doyun-gu/hack-a-bot-2026/README.md

# GridBox — Smart Infrastructure Control System

<p align="center">
  <a href="https://hackabot-2026.com">Hack-A-Bot 2026</a>
  &nbsp;&nbsp;&nbsp;&nbsp;&nbsp;
  
</p>

<p align="center">
  <strong>A £15 smart factory controller — built in 24 hours</strong><br/>
  21 Mar 2026 12:00 — 22 Mar 2026 12:00
</p>

<p align="center">
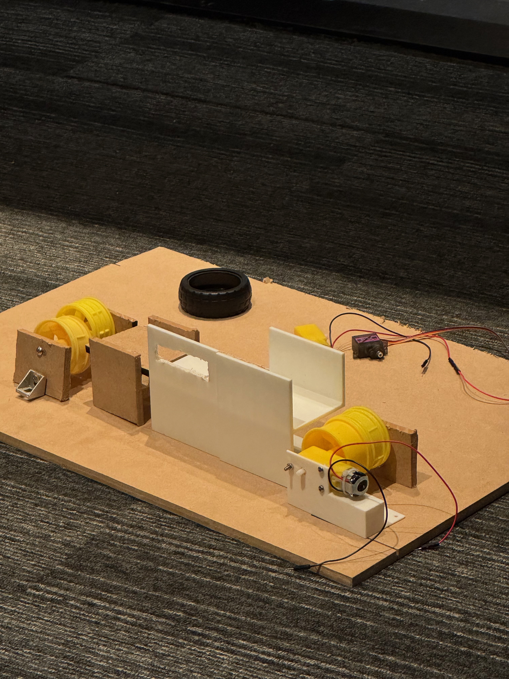
[picture p1: docs/images/build/chassis_assembled.jpeg]
GridBox — Assembled Sorting Conveyor
  
  &nbsp;&nbsp;
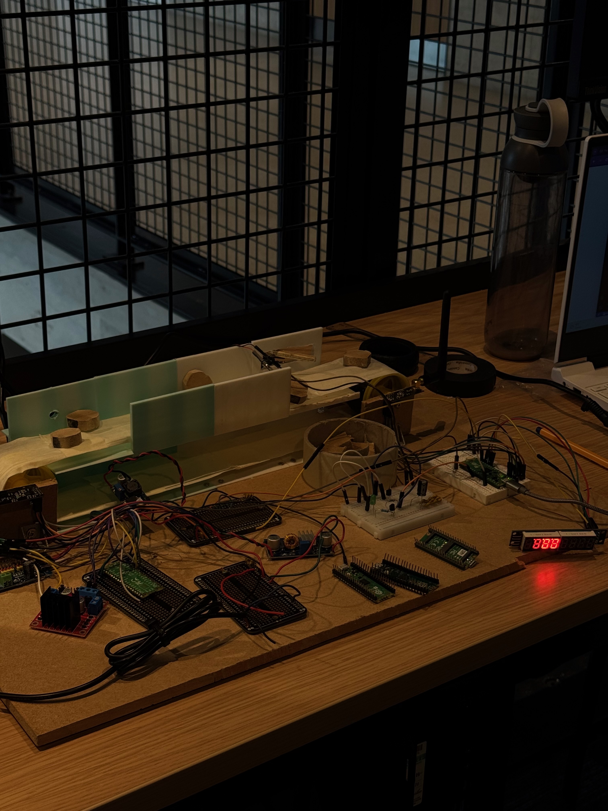
[picture p2: docs/images/build/full_system.jpeg]
GridBox — Full System with Electronics
  
</p>

<p align="center">
  <a href="docs/01-overview/gridbox-design.md">Design Doc</a> · <a href="docs/01-overview/context.md">Project Context</a> · <a href="docs/02-electrical/wiring-connections.md">Wiring Guide</a> · <a href="docs/04-team/team-plan.md">Team Plan</a>
</p>

---

## What We Built

GridBox is a miniature **smart factory** — a water bottling / sorting plant powered by recycled energy. Two Raspberry Pi Pico 2 boards work together wirelessly: one controls the factory floor, the other is a remote SCADA monitoring station.

```mermaid
graph LR
    ENERGY[Recycled Energy] --> PICO_A[Pico A: Factory Controller]
    PICO_A --> M1[DC Motor: Fan/Pump]
    PICO_A --> M2[DC Motor: Conveyor]
    PICO_A --> S1[Servo: Valve]
    PICO_A --> S2[Servo: Sort Gate]
    PICO_A -->|"nRF24L01+ wireless"| PICO_B[Pico B: SCADA Station]
    PICO_B --> OLED[OLED Dashboard]
    PICO_B --> SEG[MAX7219 7-Segment]
    PICO_A -->|"USB serial"| WEB[Laptop: Web Dashboard]
```

### Key Features

| Feature | How It Works |
|---|---|
| **Smart power management** | ADC senses current at every branch. Pico reroutes excess power. $P \propto n^3$ — 20% slower = 49% less energy |
| **Autonomous fault detection** | IMU vibration monitoring (ISO 10816) + current signature analysis. Detects bearing wear, jams, loose connections |
| **Intelligent load shedding** | Bus voltage drops → system sheds non-essential loads by priority. Critical systems stay powered |
| **Weight-based sorting** | Motor current change = item weight. Timed servo gate sorts good/bad at the end of the belt |
| **Wireless SCADA** | 6-type binary datagram protocol at 50Hz. OLED dashboard with 5 views. MAX7219 7-segment live status display |
| **Failure simulator** | Inject faults during demo — judges watch the system handle wireless dropout, motor stall, power sag, IMU failure |
| **Web dashboard** | Live graphs on laptop via USB serial. SQLite database for persistent data logging |

### The Demo

| Step | What Happens |
|---|---|
| 1 | Power on — system auto-starts, motors spin, LEDs green |
| 2 | Wireless SCADA — Pico B display shows live speed, angle, fault status |
| 3 | Place items on conveyor — sorted by weight into PASS / REJECT bins |
| 4 | Shake motor — fault detected in <100ms, motor stops, power reroutes |
| 5 | Auto-recovery — vibration drops, system restores loads automatically |
| 6 | Energy summary — "Smart mode saved 69% energy vs dumb mode" |

---

## Themes

<p align="center">
  <strong>Sustainability</strong> — Smart energy management, waste reduction, recycled power<br/>
  <strong>Autonomy</strong> — Sense, decide, and act with zero human input
</p>

---

## Tech Stack

| Layer | Technology |
|---|---|
| **Microcontrollers** | 2× Raspberry Pi Pico 2 (RP2350, ARM Cortex-M33, dual-core) |
| **Wireless** | nRF24L01+ PA+LNA, 2.4GHz, custom 6-type binary datagram protocol |
| **Sensors** | BMI160 IMU (vibration), ADC (voltage + current via 1Ω sense resistors) |
| **Actuators** | 2× DC Motor (200RPM geared), 2× MG90S Servo, via PCA9685 PWM driver |
| **Display** | 0.96" SSD1306 OLED (128×64, 5 views) + MAX7219 8-digit 7-segment |
| **Switching** | Motor driver module + 2N2222 NPN transistor for energy recycling |
| **Firmware** | MicroPython (development) + C SDK (production demo) |
| **Dashboard** | Flask + SQLite + live graphs on laptop |
| **Power** | 12V PSU → LM2596S buck (5V logic) + 300W buck-boost (motor power) |

---

## Repository Structure

```
hack-a-bot-2026/
├── test.sh                         ← One command for all tests: ./test.sh led, ./test.sh oled, etc.
│
├── firmware/                       ← Frozen firmware snapshots (flash directly)
│   ├── 01-v1/                      ← MicroPython v1 (21 modules)
│   ├── 02-v2/                      ← + datagram protocol, self-test, A/B comparison
│   ├── 03-v3/                      ← + mock data, C stubs, integration test
│   └── 04-v4/                      ← + wireless verified, architecture diagrams
│
├── src/                            ← Development source code (11,500+ lines)
│   ├── master-pico/
│   │   ├── micropython/            ← Pico A: 14 MicroPython modules
│   │   ├── c_sdk/                  ← Pico A: C production firmware (5 drivers + main.c)
│   │   └── tests/                  ← 15 hardware test scripts
│   ├── slave-pico/
│   │   ├── micropython/            ← Pico B: 9 MicroPython modules
│   │   ├── c_sdk/                  ← Pico B: C production firmware (3 drivers + main.c)
│   │   └── tests/                  ← 6 display + wireless test scripts
│   ├── shared/protocol.py          ← 6-type binary datagram protocol (32-byte packets)
│   ├── web/                        ← Flask dashboard + SQLite + mock data generator
│   ├── hardware/electronics/       ← Circuit schematics + test logs (Wooseong)
│   ├── hardware/chassis/           ← CAD + 3D print files (Billy)
│   └── tools/                      ← setup-pico.sh, flash.sh, setup-pico1.sh
│
├── docs/
│   ├── 01-overview/                ← Design doc, proposal, context, quick-start, project summary
│   ├── 02-electrical/              ← Wiring, power system, datagram, debug, failure handling,
│   │                                  motor specs, wireless reliability, energy signature
│   ├── 03-factory/                 ← Factory design, conveyor calcs, weight sensing, demo script
│   ├── 04-team/                    ← Team plan + task lists
│   └── 05-archive/                 ← Past ideas explored
│
└── media/                          ← Build progress photos + demo videos
```

---

## Codebase Stats

**259 source files — 44,186 lines of code**

### By Language
| Language | Lines |
|---|---|
| Python | 36,799 |
| C/C++ | 5,673 |
| Shell | 928 |
| HTML | 786 |

### By Component
| Component | Lines | What |
|---|---|---|
| Firmware snapshots | 25,336 | 4 frozen releases (v1–v4) |
| Master Pico | 8,509 | MicroPython + C SDK + 15 tests |
| Slave Pico | 4,989 | MicroPython + C SDK + 6 tests |
| Demo | 1,674 | Integration demo scripts |
| Web Dashboard | 1,325 | Flask + SQLite + HTML |
| Tools/Scripts | 1,260 | Flash, build, test scripts |
| Shared Protocol | 358 | Wireless datagram protocol |

---

## Build Gallery

<table>
<tr>
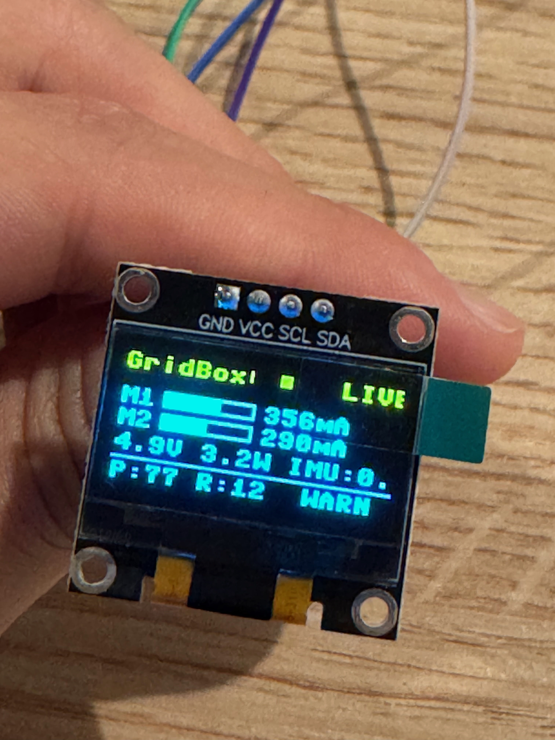
[picture p3: docs/images/build/oled_live.jpeg]
<td align="center" width="33%"><br/><em>OLED SCADA display — live readings</em></td>
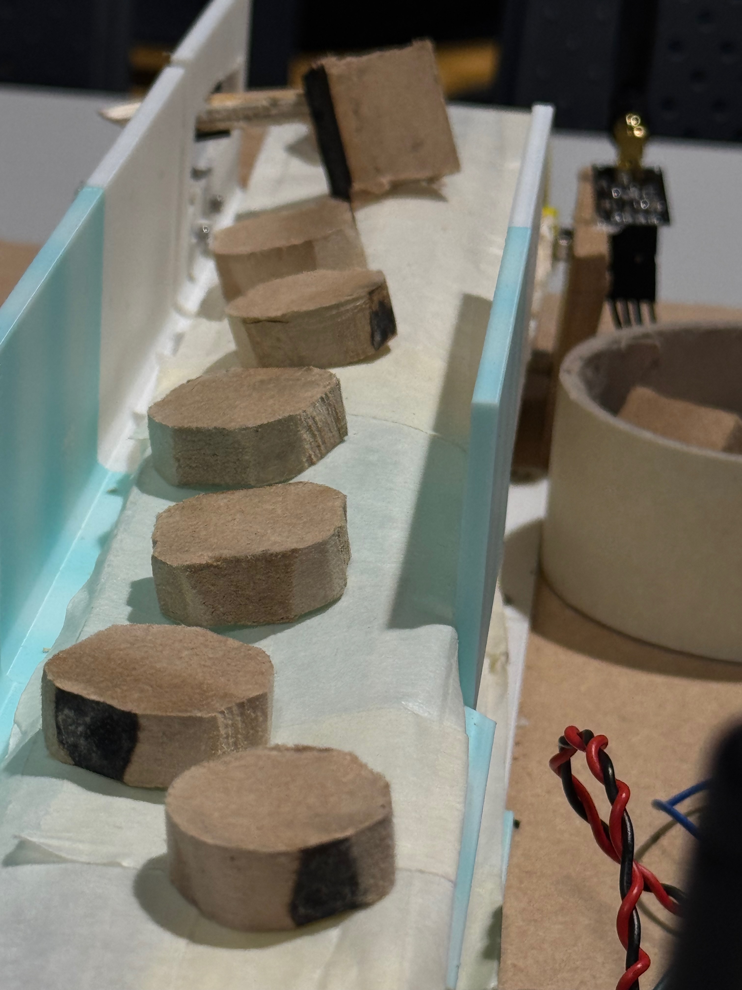
[picture p4: docs/images/build/conveyor_closeup.jpeg]
<td align="center" width="33%"><br/><em>Sorting conveyor with test objects</em></td>
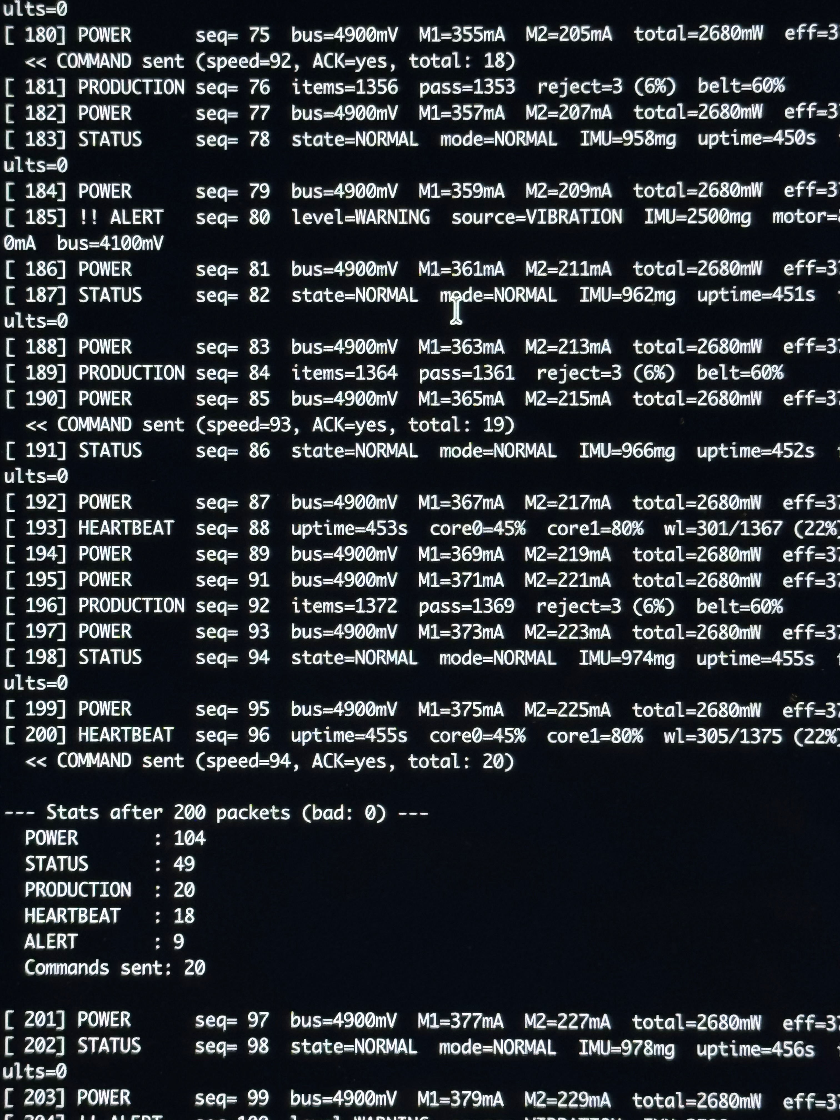
[picture p5: docs/images/build/wireless_test.jpeg]
<td align="center" width="33%"><br/><em>Wireless protocol — 200+ packets, 0 errors</em></td>
</tr>
<tr>
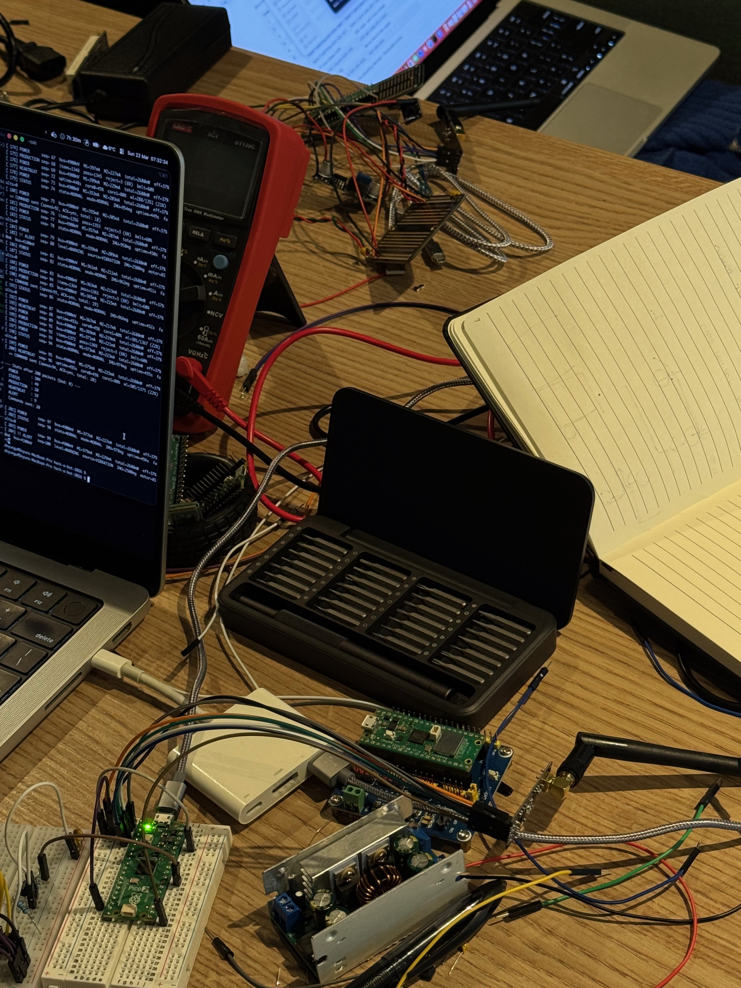
[picture p6: docs/images/build/workbench.jpeg]
<td align="center" width="33%"><br/><em>Electronics workbench</em></td>
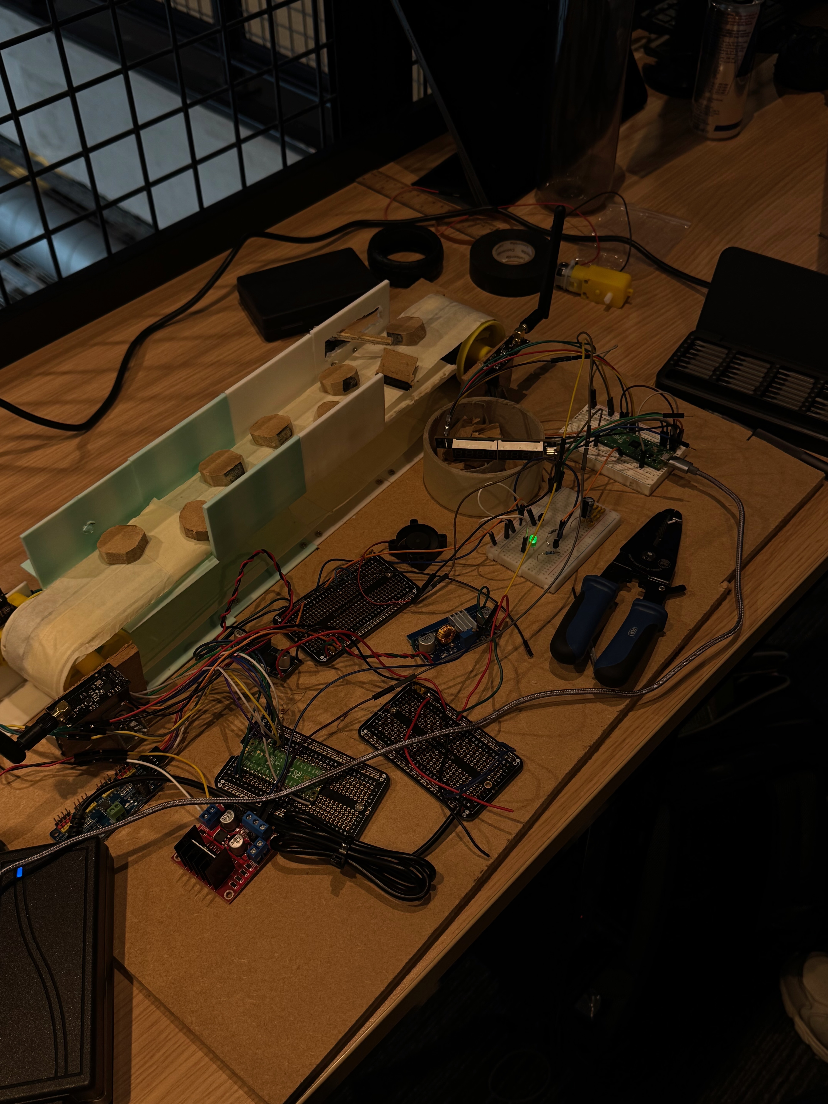
[picture p7: docs/images/build/integration.jpeg]
<td align="center" width="33%"><br/><em>Full integration — chassis + electronics</em></td>
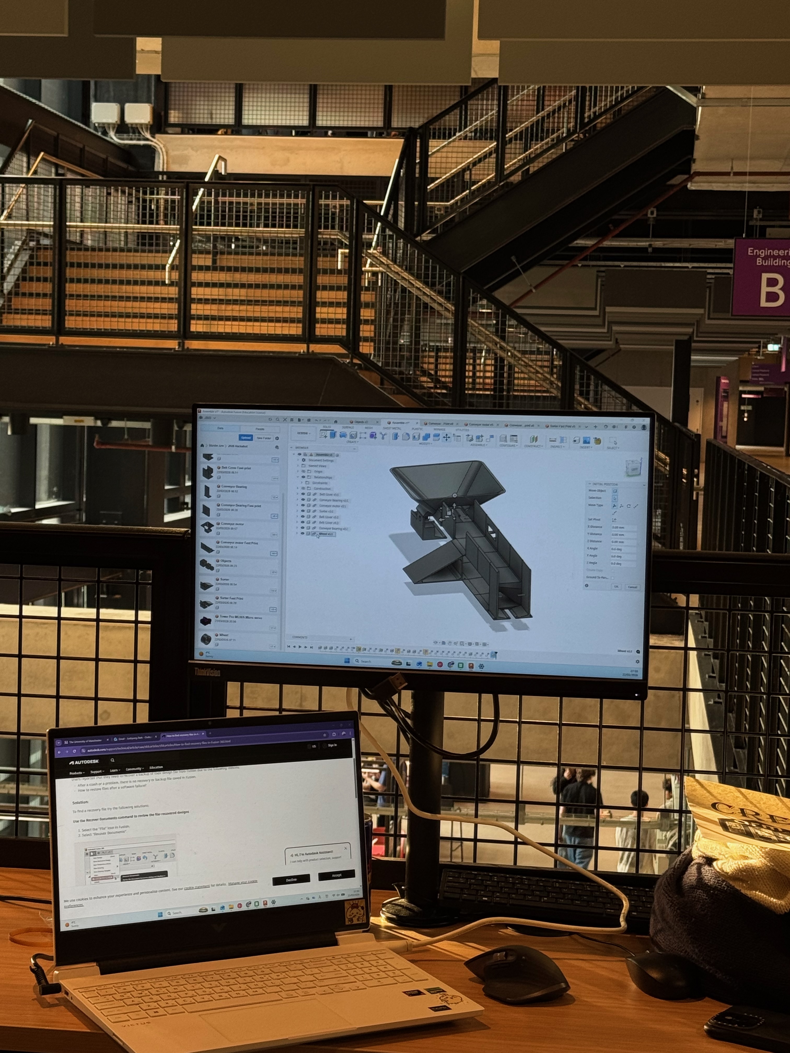
[picture p8: docs/images/build/cad_workstation.jpeg]
<td align="center" width="33%"><br/><em>Billy designing chassis in Fusion 360</em></td>
</tr>
</table>

<p align="center">
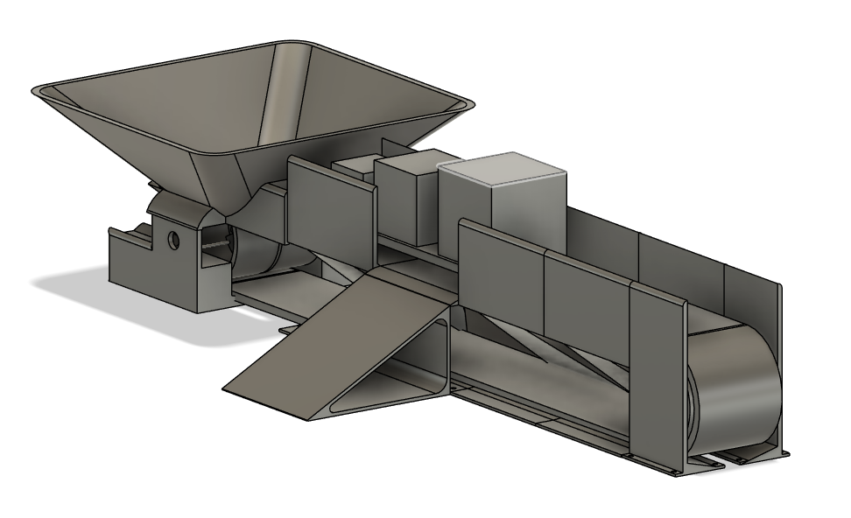
[picture p9: docs/images/chassis_cad.png]
<br/>
<em>CAD render — sorting conveyor designed by Billy Park in Fusion 360</em>
</p>

---

## Supported By

<table align="center">
<tr>
<td align="center"><a href="https://www.arm.com">ARM</a></td>
<td align="center"><a href="https://manchesterstudentsunion.com/activities/view/eeesoc">EEESoc</a></td>
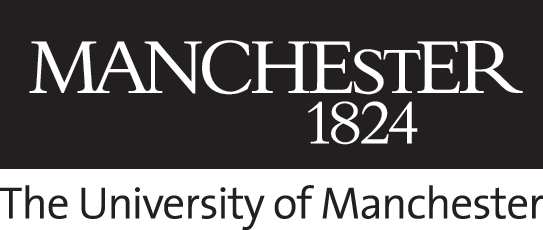
[picture p10: docs/images/uom_black.png]
UoM
<td align="center"></td>
<td align="center"><a href="https://www.makerspace.manchester.ac.uk">Makerspace</a></td>
<td align="center"><a href="https://www.quanser.com">Quanser</a></td>
</tr>
<tr>
<td align="center"><a href="https://www.intechopen.com/profiles/213610">Ice Nine</a></td>
<td align="center"><a href="https://www.amentum.com">Amentum</a></td>
<td align="center"><a href="https://www.dominos.co.uk">Dominos</a></td>
<td align="center"></td>
<td align="center"></td>
</tr>
<tr>
<td align="center"></td>
<td align="center"></td>
<td align="center"></td>
<td align="center"></td>
<td align="center"></td>
</tr>
</table>

<p align="center">
  <em><a href="https://hackabot-2026.com">Hack-A-Bot 2026</a> — Project 6: Creative — University of Manchester</em>
</p>
