doyun-gu/hack-a-bot-2026/docs/ideas/README.md

# Ideas Archive

Brainstorming and alternative ideas explored before choosing GridBox. Kept for reference.

| File | Score | Idea |
|---|---|---|
| [`idea-shortlist.md`](idea-shortlist.md) | — | Original 10 ideas (base kit only) |
| [`idea-shortlist-v2.md`](idea-shortlist-v2.md) | — | Expanded 14 ideas (with DC motor, ESP32-CAM, wheels) |
| [`tremortray-proposal.md`](tremortray-proposal.md) | 98 | NeuroSync — neurological diagnostic platform |
| [`steadyhand-proposal.md`](steadyhand-proposal.md) | 95 | SteadyHand — tremor-stabilising device |

**Chosen idea:** GridBox → see [`docs/gridbox-design.md`](../gridbox-design.md)
