doyun-gu/hack-a-bot-2026/docs/03-factory/poster-content.md

# GridBox — Poster / Slide Content

> Content for a presentation poster or display slide. Print at A1 or display on screen.

---

## Title Block

**GridBox**
*Smart Infrastructure Control for £15*

ARM + EEESoc Hack-A-Bot 2026 | [Team Name]

---

## The Problem

- **£162,000** — average cost of an industrial SCADA system for a single factory floor
- **30%** of factory energy is wasted by running motors at full speed when partial load is sufficient
- **4+ hours** average downtime per undetected equipment fault — costing UK manufacturers £180B/year

> "What if a £15 microcontroller could do the job of a six-figure control system?"

---

## The Solution

GridBox is a smart infrastructure controller built on two Raspberry Pi Pico 2s that:

1. **Senses** power on every branch via ADC + voltage dividers
2. **Decides** optimal routing using real-time fault detection
3. **Routes** power through GPIO-controlled MOSFETs
4. **Recovers** automatically from 7 fault types in <100ms

### Solution Diagram Description

*Draw or print this layout:*

```
┌─────────────────────────────────────────────────┐
│                   GRIDBOX                        │
│                                                  │
│   ┌──────────┐     2.4GHz      ┌──────────┐    │
│   │  PICO A  │ ◄─────────────► │  PICO B  │    │
│   │  Master  │    nRF24L01+    │  SCADA   │    │
│   └────┬─────┘                 └────┬─────┘    │
│        │                            │           │
│   ┌────┴────────────┐    ┌─────────┴────────┐  │
│   │  SENSE           │    │  MONITOR          │  │
│   │  • Bus voltage   │    │  • OLED display   │  │
│   │  • Motor current │    │  • Joystick       │  │
│   │  • IMU vibration │    │  • Potentiometer  │  │
│   └────┬────────────┘    └──────────────────┘  │
│        │                                        │
│   ┌────┴────────────┐                           │
│   │  CONTROL         │                           │
│   │  • MOSFET switch │                           │
│   │  • Servo gates   │                           │
│   │  • PWM motors    │                           │
│   │  • Load shedding │                           │
│   └─────────────────┘                           │
│                                                  │
│   ┌─────────────────────────────────────────┐   │
│   │  WEB DASHBOARD (Flask, localhost:8080)   │   │
│   │  Real-time charts • Fault log • History  │   │
│   └─────────────────────────────────────────┘   │
└─────────────────────────────────────────────────┘
```

---

## Key Metrics

| Metric | GridBox | Traditional SCADA |
|---|---|---|
| **Cost** | **£15** | £162,000 |
| **Energy saving** | **69%** | Baseline |
| **Fault response** | **<100ms** | Minutes (manual) |
| **Fault types detected** | **7** | Varies by config |
| **Update rate** | **100 Hz** | 1–10 Hz typical |
| **Setup time** | **Minutes** | Weeks |

---

## Tech Stack

| Layer | Technology |
|---|---|
| **Hardware** | 2x Raspberry Pi Pico 2 (RP2350, ARM Cortex-M33) |
| **Wireless** | nRF24L01+ PA+LNA, 32-byte packets at 50Hz |
| **Sensors** | BMI160 IMU (6-axis), ADC voltage/current sensing |
| **Actuators** | PCA9685 PWM (servos + motors), MOSFET switching |
| **Firmware** | MicroPython (dev) + C/C++ Pico SDK (production) |
| **Dashboard** | Flask + SQLite, real-time web UI |
| **Protocol** | Custom 6-type datagram, 8-packet rotation schedule |

---

## How It Works

### Closed-Loop Control (every 10ms)

```
SENSE → CALCULATE → DECIDE → ROUTE → VERIFY
  │         │          │        │        │
  ADC     KCL/KVL    State   MOSFET    ADC
  pins    checks    machine   GPIO    re-read
```

### Core EEE Theory

- **Affinity Laws:** $P \propto n^3$ — 20% slower = 49% less power
- **KCL:** Current balance verified at every node
- **Voltage divider:** Safe ADC measurement of bus voltage
- **Current sensing:** $I = V_{sense} / R_{sense}$ via 1 ohm resistors
- **ISO 10816:** Vibration classification for fault detection

---

## Demo Scenario: Smart Water Bottling Plant

| Station | Hardware | What It Does |
|---|---|---|
| **Pump** | DC Motor 1 | Fills bottles (PWM speed control) |
| **Fill Valve** | Servo 1 | Opens/closes water flow |
| **Conveyor** | DC Motor 2 | Moves bottles along the line |
| **Quality Gate** | Servo 2 | Sorts by weight (pass/reject) |
| **Fault Detect** | BMI160 IMU | Detects vibration anomalies |
| **Power Grid** | ADC + MOSFETs | Senses and routes power |

---

## Team

| Name | Role |
|---|---|
| [Name 1] | Firmware & Software |
| [Name 2] | Hardware & Wiring |
| [Name 3] | Demo & Presentation |
| [Name 4] | Testing & Documentation |

---

## QR Code

Link to: `https://github.com/[org]/hack-a-bot-2026`

*Generate a QR code pointing to the GitHub repo. Print at ~4cm x 4cm in the bottom-right corner of the poster.*

---

## Design Notes for Printing

- **Size:** A1 (594 x 841 mm) landscape or portrait
- **Colour scheme:** Dark blue (#1a237e) headers, white background, green (#2e7d32) for metrics
- **Font:** Sans-serif (Roboto, Inter, or similar), title 72pt, body 24pt, metrics 36pt bold
- **Layout:** Title top-centre, problem/solution left column, metrics/tech right column, diagram centre, team + QR bottom
- **Logo:** ARM + EEESoc logos in header bar if permitted
