doyun-gu/hack-a-bot-2026/docs/03-factory/demo-script.md

# GridBox — 3-Minute Demo Script

> Exactly what to say, when to say it, and what to do if something breaks.

## Roles

| Person | Role | Position |
|---|---|---|
| **Presenter** | Talks, points at things, drives the narrative | Front of table |
| **Operator** | Triggers faults, monitors laptop, manages hardware | Behind the rig |
| **Backup** | Watches dashboard, ready to switch to backup demo | At laptop |

---

## The Script

### Opening — "Who We Are" (0:00–0:15)

**Presenter says:**

> "Hi, we're [Team Name]. We built GridBox — a smart infrastructure controller that does the job of a hundred-and-sixty-two-thousand-pound industrial system, for fifteen pounds."

*[Point at the rig]*

> "This is a miniature smart water bottling plant. Two motors, two servos, sensors on every branch — all controlled by a pair of Raspberry Pi Picos talking wirelessly."

**Operator:** Power on the rig (if not already on). Confirm green LEDs are solid.

**Judges should see:** LEDs light up, OLED shows status, dashboard on laptop shows NORMAL.

---

### Normal Operation — "What It Does" (0:15–0:45)

**Presenter says:**

> "Right now, both motors are running at optimised speeds — not a hundred percent, just what's needed. The system is sensing power on every branch using ADC pins and voltage dividers."

*[Point at the dashboard on laptop]*

> "On the dashboard you can see real-time bus voltage, motor currents, and total power. That efficiency number — around eighty-two percent — that's because the Pico is only drawing what each load actually needs."

> "The fan is running at sixty-five percent, conveyor at forty-five. Under the hood, Kirchhoff's Current Law is being checked every ten milliseconds — if the numbers don't add up, the system knows something's wrong."

**Operator:** Ensure system is stable. Dashboard should show smooth sine-wave current traces.

**Judges should see:** Dashboard with live updating charts, stable readings, green status indicators.

---

### Wireless SCADA — "Two Brains, One System" (0:45–1:15)

**Presenter says:**

> "The two Picos are talking wirelessly over a 2.4GHz radio link — fifty packets per second, six different data types. Watch the display on Pico B."

*[Point at the MAX7219 7-segment display]*

> "That's live motor speed, servo angle, and system status — transmitted wirelessly from the controller. No wires between the two boards."

> "The motor speed is optimised using the Affinity Laws: P is proportional to n-cubed. A twenty percent speed reduction saves forty-nine percent power. That's not software magic, that's thermodynamics."

**Operator:** Ensure the MAX7219 display is cycling through pages (speed, voltage, items, IMU data).

**Judges should see:** MAX7219 display updating live, dashboard showing wireless packet stats, both Picos operating independently.

---

### Sorting Demo — "Smart Decisions" (1:15–1:45)

**Presenter says:**

> "Items are moving along the conveyor now. The system detects each one by sensing the current spike — heavier items draw more current through the motor."

*[Point at the sorting gate]*

> "Watch the gate — it classifies each item by weight and fires the servo at exactly the right moment. The travel time is calculated from belt speed and distance. Pass items go straight, rejects get diverted."

> "We've sorted [X] items so far with a [Y] percent reject rate. All tracked, all logged, all on the dashboard."

**Operator:** Feed items onto the conveyor if using physical props. Otherwise, let the automatic cycle run.

**Judges should see:** Servo gate moving, item counts incrementing on dashboard, pass/reject stats updating.

---

### Fault Injection — "When Things Go Wrong" (1:45–2:15)

**Presenter says:**

> "Now, the real test. Every industrial system breaks — the question is how it recovers."

*[Nod to operator]*

> "We're going to shake the motor to simulate a vibration fault."

**Operator:** Physically shake the motor mount, or press the fault-inject button.

**Presenter says:**

> "The BMI160 IMU detected acceleration above two g. The system went through DRIFT, WARNING, and into FAULT — all in under a hundred milliseconds. It stopped the affected motor, shed non-critical loads, and sent an alert over wireless."

*[Point at dashboard — red indicators, fault log]*

> "And now watch — it self-heals. The vibration drops, the system restores loads in priority order. Motor one first, then the recycle path. No human intervention."

**Judges should see:** Red status on dashboard, fault logged, then automatic recovery. Green status returns.

---

### The Comparison — "Dumb vs Smart" (2:15–2:30)

**Presenter says:**

> "Let's put a number on it. We ran both motors at a hundred percent — dumb mode, like a traditional system. Total power: [X] watts."

> "Then smart mode — optimised speeds, load shedding, fault recovery. Total power: [Y] watts. That's a sixty-nine percent energy saving. On a real factory floor, that's the difference between profit and shutdown."

**Operator:** If A/B comparison didn't run automatically, trigger it via SCADA button.

**Judges should see:** Comparison numbers on dashboard — dumb vs smart side by side.

---

### Closing Pitch — "Why This Matters" (2:30–2:45)

**Presenter says:**

> "Industrial SCADA systems cost a hundred and sixty-two thousand pounds. They need proprietary hardware, licensed software, trained technicians."

> "GridBox does the same job for fifteen pounds. Two Picos, some MOSFETs, and clever firmware. It senses, decides, routes, and recovers — all in a closed loop running at a hundred hertz."

> "Every GPIO pin is a switch. Every ADC pin is a sensor. The Pico isn't just controlling the grid — it IS the grid's switching fabric."

> "Thank you. We're happy to take questions."

---

## If Something Fails

### Wireless link drops

**Presenter says:** "The wireless link dropped — this actually demonstrates our fault tolerance. The master Pico continues operating autonomously. Watch — all local control is still working, just the dashboard stops updating."

**Operator:** Show OLED on the Pico — it still displays local data.

### Motor doesn't start

**Presenter says:** "The motor didn't start — let me show you the self-test."

**Operator:** Reset the Pico. The LED blink codes will show which test failed (1 blink = I2C, 2 = SPI, etc.). Swap to backup Pico if needed.

### Dashboard freezes

**Operator:** Refresh the browser. If the Flask server crashed, restart with `python app.py --no-serial --mock` to show mock data instead.

**Presenter says:** "We'll switch to simulated data to keep the demo moving — the firmware is the same, we're just feeding it from software instead of hardware."

### Sorting gate doesn't fire

**Presenter says:** "The gate servo isn't responding — but look at the dashboard, the classification logic is still working. The system detected the item, classified it correctly, and scheduled the sort. The servo timing is calculated from belt speed — we can debug the mechanical connection after."

### Nothing works at all

**Presenter says:** "Let me walk you through the architecture on the dashboard with simulated data."

**Operator:** Run `python app.py --no-serial --mock` — full 3-minute demo sequence plays on the dashboard. Present the same talking points with the simulated data.

---

## Key Numbers to Memorise

| Metric | Value | Context |
|---|---|---|
| Cost | **£15** vs £162,000 | 10,800x cheaper |
| Energy saving | **69%** | Smart vs dumb mode |
| Response time | **<100ms** | Fault detection to action |
| Fault types | **7** | Vibration, overcurrent, undervoltage, intermittent, jam, stall, power sag |
| Loop speed | **100 Hz** | 10ms per cycle |
| Wireless | **50 Hz** | 32-byte packets, 6 types |
| Sorting | **85%+ pass rate** | Weight-based classification |

---

## Timing Summary

| Time | Phase | Duration |
|---|---|---|
| 0:00–0:15 | Opening | 15s |
| 0:15–0:45 | Normal operation | 30s |
| 0:45–1:15 | Wireless SCADA link | 30s |
| 1:15–1:45 | Sorting demo | 30s |
| 1:45–2:15 | Fault injection + recovery | 30s |
| 2:15–2:30 | Dumb vs Smart comparison | 15s |
| 2:30–2:45 | Closing pitch | 15s |
| 2:45–3:00 | Buffer / questions | 15s |
