doyun-gu/hack-a-bot-2026/docs/03-factory/GridBox-Presentation.pptx

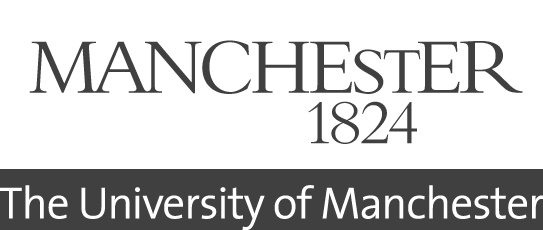
[picture p29: figure]

GridBox

Smart Infrastructure Control for £15

"What if a £15 microcontroller could replace a £162,000 industrial system?"

ARM + EEESoc | Hack-A-Bot 2026

Doyun Gu · Wooseong · Billy

## Slide 2

The Problem

30%
of factory energy
is wasted

Motors run at full speed
when partial load is enough

£180B/year
lost to undetected
equipment faults

4+ hours average
downtime per fault

£162,000+
cost of industrial
SCADA system

80% of small factories
priced out

Small and medium factories can't afford Industry 4.0.
They run blind — no monitoring, no fault detection, no optimisation.
When equipment fails, they find out the hard way.

## Slide 3

Our Solution — GridBox

PICO A — Master
Grid Controller

IMU · PCA9685 · ADC
Motor driver · Recycle path

PICO B — Slave
SCADA Station

OLED · MAX7219 · nRF
Wireless dashboard

nRF24L01+ Wireless
2.4GHz · 250kbps
32-byte datagrams

Closed-Loop Control (every 10ms):

SENSE (ADC) → CALCULATE (KCL/KVL) → DECIDE (firmware) → ROUTE (GPIO) → VERIFY (ADC)

Demo: Smart Water Bottling Plant

Stage | Hardware | What Happens
Pump | DC Motor 1 | Fills bottles at PWM-controlled speed
Fill Valve | Servo 1 (PCA9685) | Opens/closes water flow
Conveyor | DC Motor 2 | Moves bottles along the line
Sort Gate | Servo 2 (PCA9685) | Directs good/reject bottles
Fault Detect | BMI160 IMU | Vibration monitoring (ISO 10816)
Energy Recycle | 2N2222 + Cap + LED | Captures and reuses wasted energy

## Slide 4

Technical Innovation

The Pico IS the Power Grid

ADC pins = power sensors
GPIO pins = electronic switches
Firmware = brain that decides
Closed loop = autonomous control

IMU Fault Detection

£2 BMI160 replaces
£18,000 equipment

Detects: bearing wear,
cavitation, jams, leaks

EEE Theory Applied

Affinity Laws: P ∝ n³
KCL/KVL energy balance
ISO 10816 vibration classification
Current sensing: I = V/R

Wireless SCADA

6-type datagram protocol
200+ packets, 0 errors

Bidirectional:
commands + telemetry

Energy Recycling

GPIO routes excess
power to storage

LED proves concept:
charge → glow → fade

Key insight: 20% speed reduction = 49% power saving (Affinity Laws: P ∝ n³)

## Slide 5

What We Built

Metric | Result | Significance
Cost | £15 total BOM | 10,800x cheaper than industrial SCADA
Wireless | 200+ packets, 0 errors | 6 datagram types, bidirectional
Wiring | 77% complete (48/66 wires) | 10/13 tasks done
Firmware | 28 MicroPython modules | 16 master + 12 slave + C SDK
Tests | 35+ test scripts | Every component verified individually
Docs | 35+ documents | Full design doc, wiring tables, diagrams
Commits | 210+ commits | 3-person team, 24-hour hackathon

Hardware Verified:

nRF24L01+ wireless (both Picos) — SPI status 0x0E, channel read/write OK
Two-Pico wireless link — standalone master + USB slave, datagram protocol
MAX7219 7-segment display — all digits, brightness, flash animations
BMI160 IMU — I2C connected, chip ID verified
Motor driver — connected and wired via PCA9685 PWM
Recycle path — 2N2222 + capacitor + LED discharge indicator

£15 vs £162,000 — Same job, 10,800x cheaper

## Slide 6

GridBox

Smart Infrastructure Control for £15

Thank you — we're happy to take questions.

Doyun Gu · Wooseong · Billy | University of Manchester
