doyun-gu/hack-a-bot-2026/docs/demo.pdf

# Hack-A-Bot 2026 Project 6: Grid Box

Doyun Gu
Wooseong Jeong
Junbyeong Park

# Table of Content

- Problem & Our Solution
- System Architecture
- Technical Summary
- Theory
- Result & Progress
- Conclusion

Hack-A-Bot 2026 Project 6: Creativity

# Table of Content

- Problem & Our Solution
- System Architecture
- Technical Summary
- Theory
- Result & Progress
- Conclusion

# Problem & Our Solution

30%
of factory energy
is wasted

Motors run at full speed
when partial load is enough

£180B/year
lost to undetected
equipment faults

4+ hours average
downtime per fault

£162,000+
cost of industrial
SCADA system

80% of small factories
priced out

Factories optimise how much energy they USE, but nobody captures the
energy they've already LOST.

Braking, load transitions, idle cycles that energy becomes heat. In a car, regenerative braking recovers 30%. In a factory?

Nothing. Because regen systems cost £5,000+.

# Our Solution

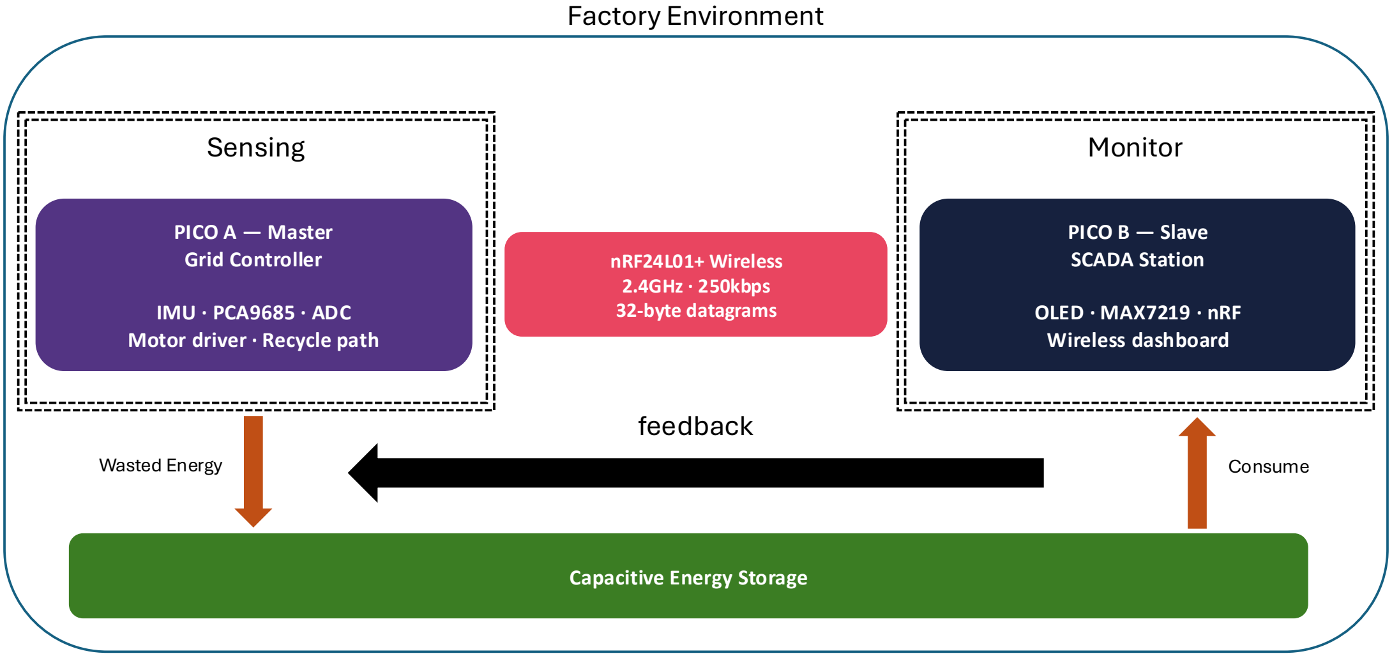
[picture p30: figure]
PICO A — Master Grid Controller; IMU · PCA9685 · ADC Motor driver · Recycle path; nRF24L01+ Wireless 2.4GHz · 250kbps 32-byte datagrams; PICO B — Slave SCADA Station; OLED · MAX7219 · nRF Wireless dashboard; Factory Environment; feedback; Capacitive Energy Storage; Sensing; Monitor; Wasted Energy; Consume

# Systematic Architecture

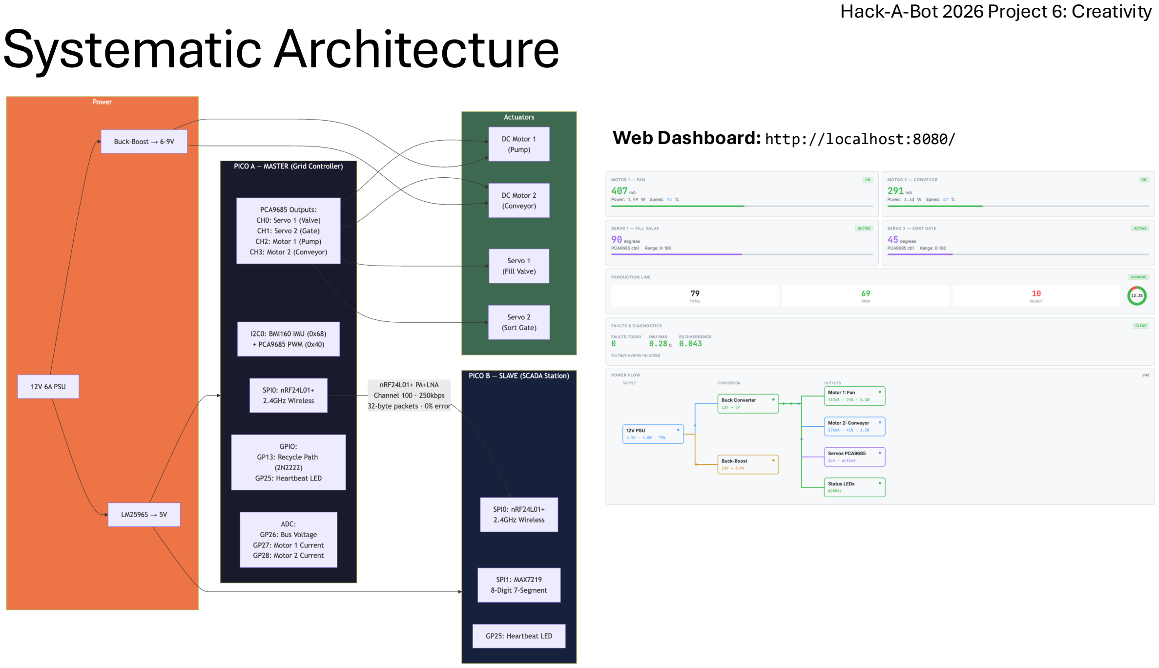
[picture p31: page 6]

Web Dashboard: http://localhost:8080/

## Technical Summary - Custom 6 type Datagram Protocol

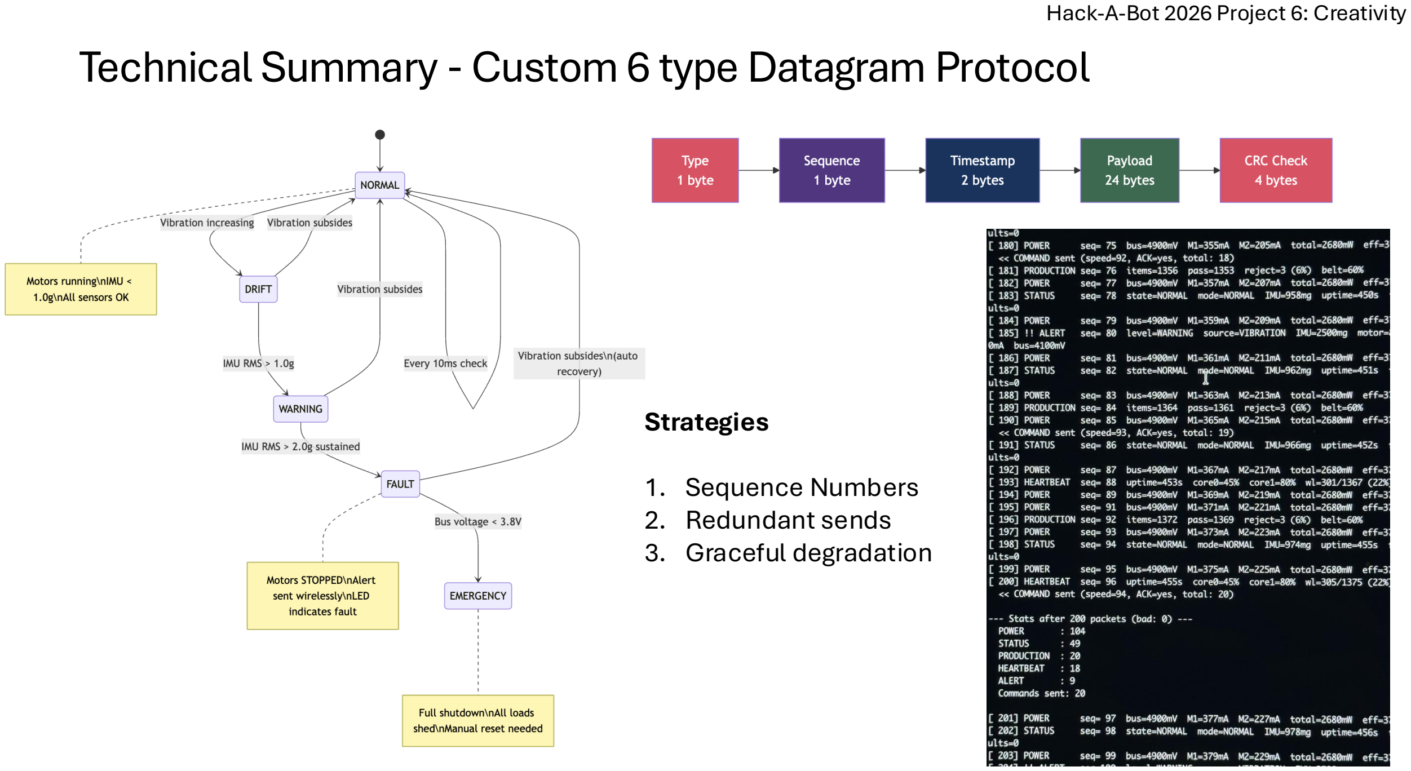
[picture p32: page 7]

Strategies

1. Sequence Numbers
2. Redundant sends
3. Graceful degradation

## Applied Engineering: Closed-Loop Power Control

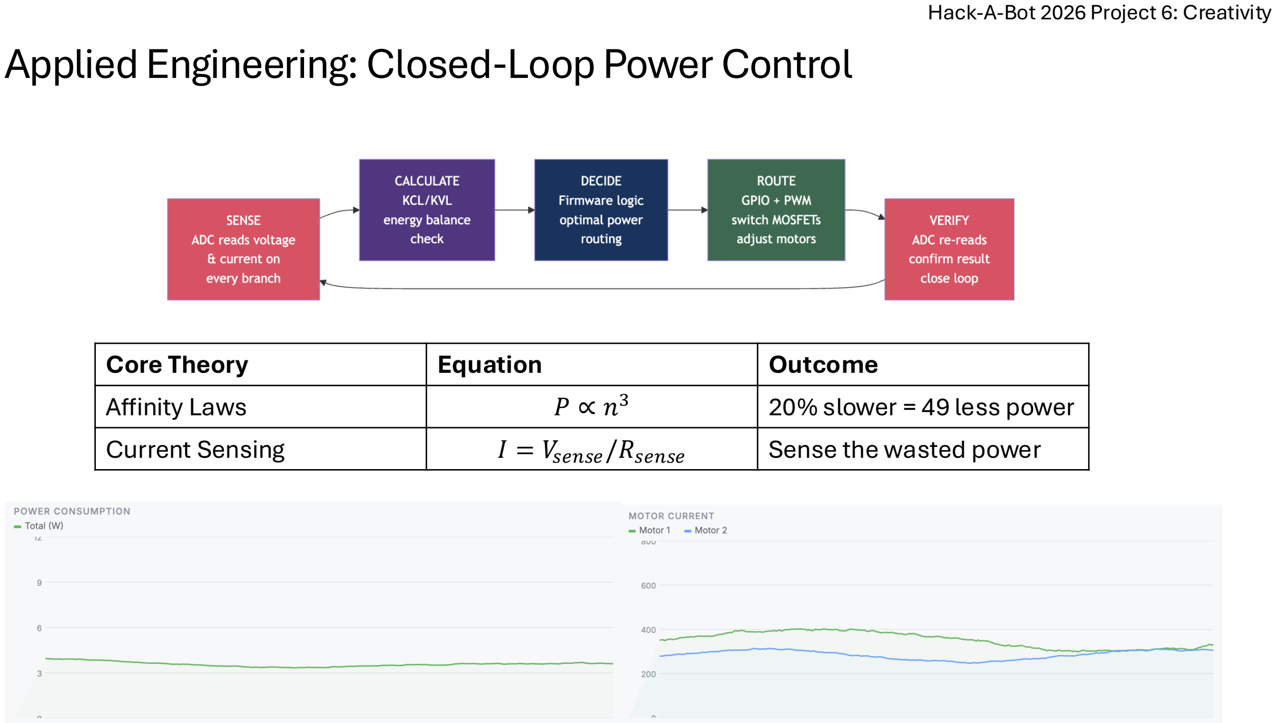
[picture p33: page 8]

Core Theory | Equation | Outcome
Affinity Laws | P ∝ n 3 | 20% slower = 49 less power
Current Sensing | I = Vsense/Rsense | Sense the wasted power

## System Implementation Timeline

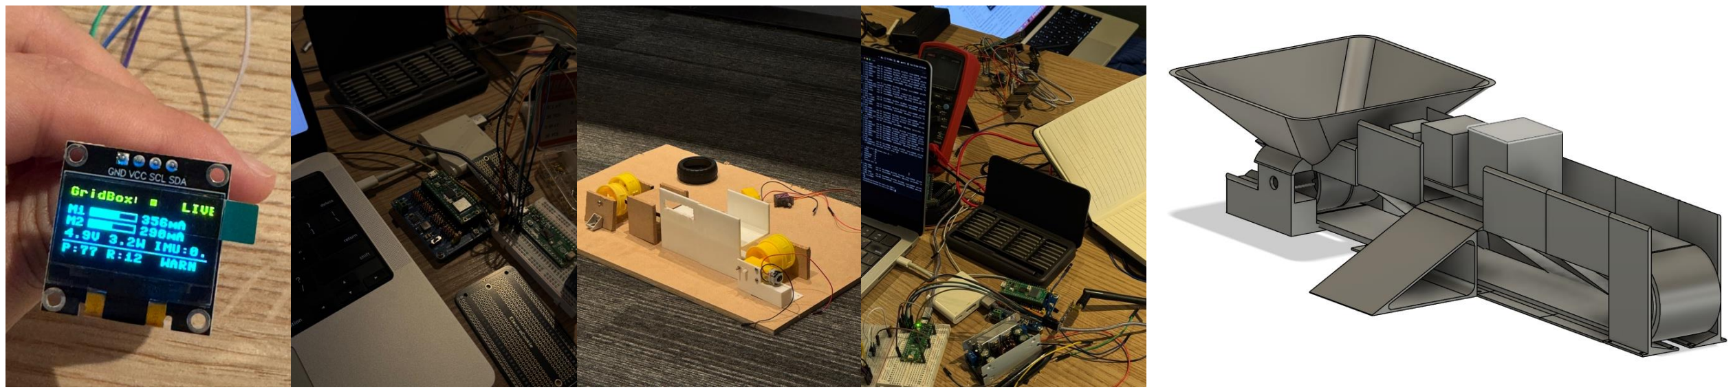
[picture p34: figure]

## Failure Analysis

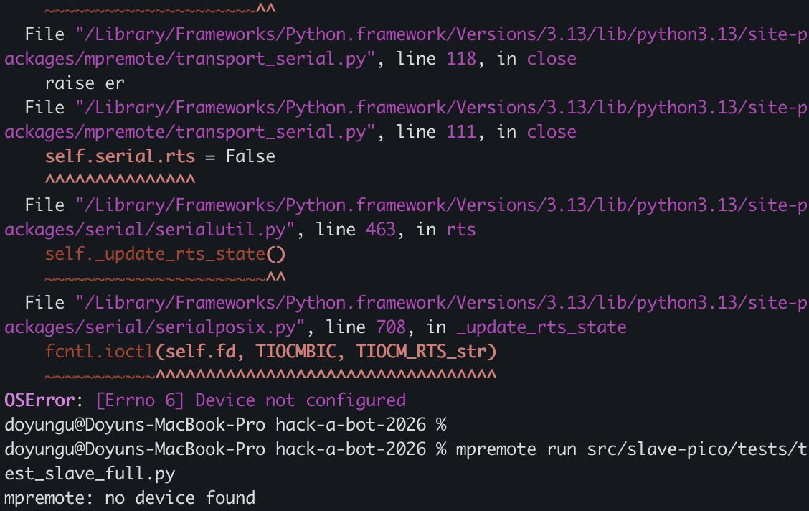
[picture p35: figure]

3.3 mA × 100 = 330 mA

Max Collector Current: 880 mA

Max Gain Current: 330 mA

We had motor for cooling and when the motor was turned off, there was reverse polarity voltage: 20 V – BURNT!

## Thank you for Listening

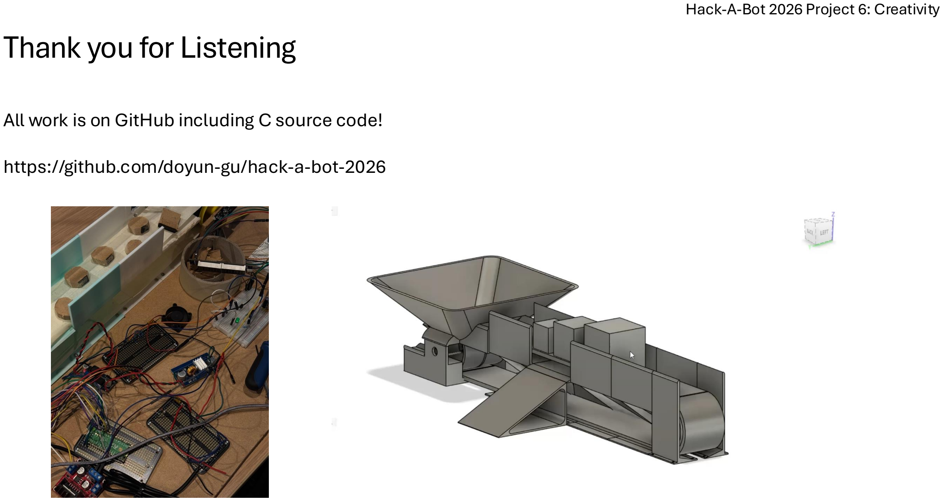
[picture p36: page 11]

All work is on GitHub including C source code!

https://github.com/doyun-gu/hack-a-bot-2026
