doyun-gu/hack-a-bot-2026/docs/05-archive/ideas/steadyhand-proposal.md

# SteadyHand — Tremor-Stabilising Assistive Device

> "Noise-cancelling headphones for physical movement"

**Theme:** Assistive Technology + Autonomy (semi-autonomous)
**Score: 95/100** — Highest ranked idea

---

## The Problem

| Stat | Detail |
|---|---|
| **10 million+** | people worldwide live with Parkinson's disease |
| **7 million** | in the US alone have essential tremor |
| **25%** | of adults over 65 have age-related tremor |
| **25-50%** | of stroke survivors develop upper limb tremor |
| **£200+** | cost of Liftware Steady (Google's stabilising spoon) |
| **~£15** | estimated cost of SteadyHand from our kit |

People with tremor can't eat independently, can't carry a cup of water, can't hold a phone steady. It strips dignity from daily life. Existing solutions are expensive or don't exist.

---

## System Architecture

```mermaid
graph LR
    subgraph A["Pico A — Wrist Sensor"]
        A1[BMI160 IMU]
        A2[Joystick]
        A3[nRF24L01+ TX]
        A4[Fall Detection]
    end

    subgraph B["Pico B — Handheld Platform"]
        B1[nRF24L01+ RX]
        B2[PID Controller]
        B3[PCA9685]
        B4[Servo A: roll]
        B5[Servo B: pitch]
        B6[OLED]
    end

    A1 --> A3
    A1 --> A4
    A2 --> A3
    A3 -->|"~2ms"| B1
    B1 --> B2
    B2 --> B3
    B3 --> B4
    B3 --> B5
    B1 --> B6
```

| Component | Location | Role |
|---|---|---|
| BMI160 IMU | Pico A (wrist) | 6-axis at 100Hz, I2C |
| Joystick | Pico A | Mode select, sensitivity, fall cancel |
| nRF24L01+ TX | Pico A | Streams roll/pitch/tremor/fall at 100Hz |
| Fall Detection | Pico A Core 1 | Freefall → Impact → Immobility state machine |
| PID Controller | Pico B | error = 0° − tilt, correction = Kp·e + Kd·de/dt |
| PCA9685 | Pico B | 16-ch PWM servo driver via I2C |
| Servo A | Pico B | Roll compensation |
| Servo B | Pico B | Pitch compensation |
| OLED 0.96" | Pico B | Health dashboard, 6 display modes |

---

## Control Loop

```mermaid
flowchart LR
    START([100Hz loop]) --> READ[Read BMI160]
    READ --> FILTER[Complementary filter]
    FILTER --> MODE{Mode?}
    MODE -->|Stabiliser| PID[PID correction]
    MODE -->|Rehab| SCORE[Steadiness score]
    PID --> SERVO[Set servos via PCA9685]
    SERVO --> TX[Transmit wireless]
    SCORE --> TX
    TX --> OLED[Update OLED]
    OLED --> START
```

| Step | Detail |
|---|---|
| Complementary filter | roll = 0.98 × prev_roll + gyro × dt + 0.02 × accel_roll |
| PID correction | error = 0° − angle; correction = Kp·e + Kd·de/dt |
| Set servos | servo_angle = 90° + correction; A = roll, B = pitch |
| Rehab score | % time within ±2° of level |
| Total latency | ~4ms: IMU (1ms) + filter (0.1ms) + wireless (2ms) + PID (0.1ms) + servo (0.5ms) |

**Total latency: ~4ms** — IMU read (1ms) + Filter (0.1ms) + Wireless (2ms) + PID (0.1ms) + Servo (0.5ms)

---

## Fall Detection (Parallel on Core 1)

```mermaid
stateDiagram-v2
    [*] --> MONITORING: 100Hz sampling

    MONITORING --> FREEFALL: accel ≈ 0g
    FREEFALL --> MONITORING: timeout 0.5s

    FREEFALL --> IMPACT: accel spike > 3g
    IMPACT --> MONITORING: movement resumes

    IMPACT --> IMMOBILE: no movement 10s

    IMMOBILE --> ALERT: SOS sent, LED red
    ALERT --> CANCELLED: joystick press within 15s
    ALERT --> CONFIRMED: no cancel after 15s

    CANCELLED --> MONITORING: resume
    CONFIRMED --> MONITORING: manual reset
```

---

## Two Modes — Same Hardware

```mermaid
graph LR
    SWITCH[Joystick press] --> MODE1[Mode 1: Stabiliser]
    SWITCH --> MODE2[Mode 2: Rehab Trainer]
```

| Mode | Servos | Purpose | Output |
|---|---|---|---|
| Stabiliser | Active — cancel tremor | Daily life use | Spoon/cup stays level |
| Rehab Trainer | Off — measure tremor | Clinical scoring | Steadiness score + ball test |

---

## Who Uses This?

### Healthcare Users

```mermaid
mindmap
  root((SteadyHand Users))
    Healthcare
      Parkinson's 10M+
      Essential tremor 7M
      Post-stroke 25-50%
      Elderly 15-25% over-65
      Cerebral palsy 17M
      Multiple sclerosis 2.8M
    Household
      Eating and drinking
      Video calls
      Pouring liquids
      Art therapy
    Professional
      Surgeons and dentists
      Lab technicians
      Photographers
    Clinical
      Occupational therapists
      Neurologists
```

---

## Household Applications (with our limited sensors)

We only have **IMU + Joystick + Servos** — no cameras, no force sensors, no extra inputs. But that's enough:

| Use Case | What's on the Platform | Why It Matters |
|---|---|---|
| **Eating** | Spoon / fork clip | #1 daily need — restores independent eating |
| **Drinking** | Small cup holder | Prevents spilling hot drinks (burn risk for elderly) |
| **Video calls** | Phone cradle | Steady image for elderly talking to family — no shaky camera |
| **Medication** | Pill tray | Prevents dropping small pills — safety critical |
| **Writing** | Pen holder | Steadier handwriting for signing documents, letters |
| **Art therapy** | Brush holder | Rehab activity — painting helps motor recovery |
| **Pouring** | Small bottle cradle | Pour liquid without spilling (cooking, lab) |

All achieved by **swapping what clips onto the same 5x6cm platform**. One device, many attachments.

---

## Joystick Usage

The joystick serves **four critical functions** — not filler:

```mermaid
graph LR
    JOY[Joystick] --> BTN[Button]
    JOY --> X[X-axis]
    JOY --> Y[Y-axis]
    BTN -->|short| MODE[Toggle mode]
    BTN -->|3s hold| CAL[Calibrate zero]
    BTN -->|during alert| CANCEL[Cancel SOS]
    X --> SENS[Servo sensitivity]
    Y --> SCROLL[Scroll OLED]
```

| Input | Action |
|---|---|
| Button short press | Toggle Stabiliser ↔ Rehab |
| Button 3s hold | Calibrate zero point (set current angle as level) |
| Button during alert | Cancel SOS — "I'm OK" |
| X-axis left | Gentle sensitivity (elderly) |
| X-axis right | Aggressive sensitivity (strong tremor) |
| Y-axis up/down | Scroll OLED: Spirit Level → Waveform → Stats → Calibration → Rehab |

### 3D Printed Joystick Adapter (if available)

If you have access to a 3D printer, you could print a **thumb-grip cap** that sits on the joystick to make it easier for tremor patients to use (larger surface, textured grip). But the stock joystick works fine for the demo.

---

## Physical Build

```mermaid
graph TB
    TOP[Top plate: spoon/cup clip]
    MID[Actuation layer: servos + push rods]
    BASE[Handle: Pico B + electronics]
    TOP --- MID --- BASE
```

| Layer | Components | Notes |
|---|---|---|
| Top plate | 5×6cm perfboard, spoon/cup clip | Moving platform |
| Actuation | M3 ball joint, Servo A (roll), Servo B (pitch), 22AWG push rods | Rods push edges of top plate |
| Handle/base | Pico B + PCA9685 + nRF24L01+ | User grips here; ~15cm × 6cm × 8cm |

**Dimensions:** ~15cm long, ~6cm wide, ~8cm tall
**Weight of moving part:** ~70g (platform + spoon)
**Assembly time:** ~2 hours

### What MG90S Can Handle

| Object | Weight | Works? |
|---|---|---|
| Spoon (empty) | ~40g | Yes — fast response |
| Spoon with food | ~60-80g | Yes |
| Small cup (espresso) | ~120g | Yes |
| Phone | ~180g | Borderline |
| Full mug | ~350g | No — too heavy |

---

## OLED Display Modes

| Mode | Screen | What It Shows | Who It's For |
|---|---|---|---|
| **1. Spirit Level** | Dot + crosshair, tilt angles | Real-time platform tilt — dot on cross = level | Live demo for judges |
| **2. Waveform** | Raw tremor wave vs flat compensated line | Before/after comparison + "78% reduction" | Proving the concept works |
| **3. Stats** | Duration, avg tremor, peak, stability %, corrections count | Session-level clinical data | Therapists / doctors |
| **4. Calibration** | Zero-point setting + sensitivity bar | Set what "level" means for this user | Initial setup |
| **5. Rehab** | Ball position dot + steadiness score + best today | Real-time rehab exercise scoring | Patients in therapy |
| **6. Fall Alert** | "FALL DETECTED" + countdown to SOS | 15-second cancel window | Emergency safety net |

Cycled with joystick Y-axis (up/down).

See `docs/images/steadyhand_oled_modes.png` for rendered mockups of each screen.

---

## Demo Script

```mermaid
graph LR
    S1[1. Setup] --> S2[2. Servos OFF]
    S2 --> S3[3. Servos ON]
    S3 --> S4[4. Show OLED]
    S4 --> S5[5. Rehab mode]
    S5 --> S6[6. Judge tries]
```

| Step | What Judges See |
|---|---|
| 1. Setup | Spoon on platform with cereal |
| 2. Servos OFF | Shake hand — cereal falls off |
| 3. Servos ON | Same shaking — cereal STAYS ON |
| 4. Show OLED | Waveform mode: "78% reduction" visible |
| 5. Rehab mode | Ball on platform, score: 67% |
| 6. Judge tries | They shake it — spoon stays level |

**Drop line:** *"A Liftware Steady costs £200. We built this for £15."*

---

## Build Timeline

```mermaid
gantt
    title SteadyHand — 12 Hour Build Plan
    dateFormat HH:mm
    axisFormat %H:%M

    section Critical Path
    nRF24L01+ wireless link confirmed     :crit, w, 00:00, 1h
    BMI160 IMU + complementary filter      :crit, i, after w, 1h
    PCA9685 + servo PID control            :crit, p, after i, 1h
    End-to-end stabilisation working       :crit, e, after p, 1h

    section Mechanical
    Platform + pivot + push rods           :m, after e, 1h
    Spoon mount + handle assembly          :h, after m, 1h

    section Software Polish
    OLED display modes (4 screens)         :o, after h, 1h
    Fall detection on Core 1               :f, after o, 30min
    Rehab trainer mode                     :r, after f, 30min

    section Documentation
    Wiring diagram + README                :d, after r, 1h
    Architecture diagrams                  :a, after d, 30min

    section Final
    PID tuning + reliability testing       :t, after a, 1h
    Practice demo                          :demo, after t, 30min
```

---

## Scoring Breakdown

| Category | Score | Why |
|---|---|---|
| **Problem Fit (30)** | **29** | 10M+ Parkinson's patients. Affects eating — most basic human need. 10+ user groups. Household + clinical + professional |
| **Live Demo (25)** | **24** | Cereal-on-spoon before/after. OLED shows quantified improvement. Dual-mode demo. Judge tries it |
| **Technical (20)** | **19** | Complementary filter, PID control, 100Hz IMU, 4ms latency, dual-core, wireless streaming, 4 OLED modes |
| **Innovation (15)** | **14** | "Noise-cancelling for movement." Dual-mode (stabiliser + rehab). DIY Liftware for £15. Household attachment system |
| **Docs (10)** | **9** | Mermaid diagrams, control flow, architecture, OLED mockups, mechanical drawings |
| **Total** | **95** | |

---

## vs Competitors

| Feature | Liftware Steady | Apple Watch | SteadyHand |
|---|---|---|---|
| **Price** | £200 | £400+ | ~£15 |
| **Tremor cancellation** | Yes | No | Yes |
| **Fall detection** | No | Yes | Yes |
| **Rehab scoring** | No | No | Yes |
| **Clinical metrics** | No | Heart rate | Tremor amp, freq, reduction %, stability |
| **Phone required** | No | Yes (iPhone) | No |
| **Swappable attachments** | No (spoon only) | N/A | Yes (spoon, cup, phone, pen) |
| **Open source** | No | No | Yes |

---

## Risks & Mitigations

| Risk | Mitigation |
|---|---|
| MG90S too slow for fast tremors (>6Hz) | Focus on slow/medium tremor. Show % improvement, not perfection |
| Mechanical assembly takes too long | Pre-plan dimensions. Simple Z-wire push rods. Budget 2h max |
| PID tuning is fiddly | Start P+D only. Tune Kp first, add Kd for damping. Skip Ki |
| "Apple Watch does this" | "Apple Watch detects falls. SteadyHand actively cancels tremor. One monitors, ours solves." |
| Wireless latency spikes | Moving average on received data. Fallback to last known angle |
