doyun-gu/hack-a-bot-2026/docs/images/factory_hvac_system.png

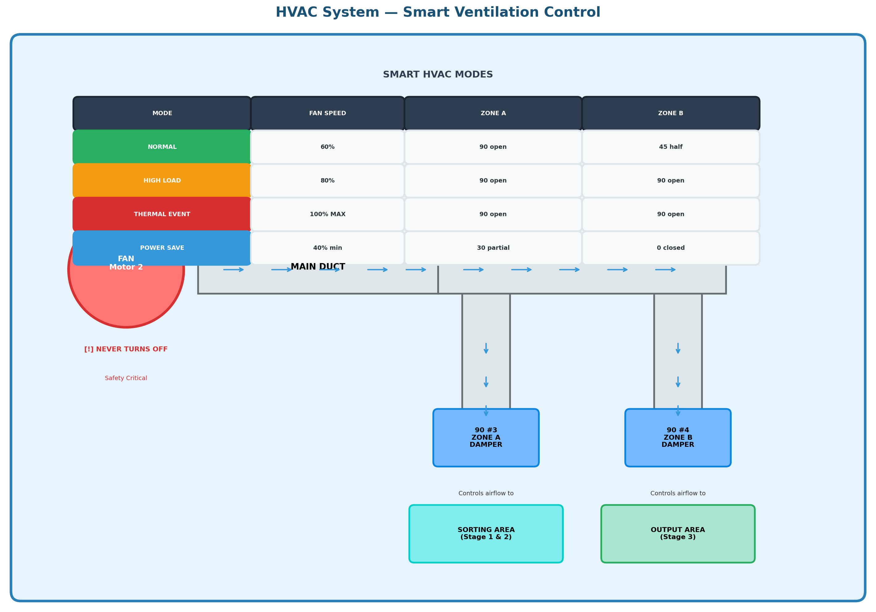
docs/images/factory_hvac_system.png
