doyun-gu/hack-a-bot-2026/docs/images/factory_side_view_full.png

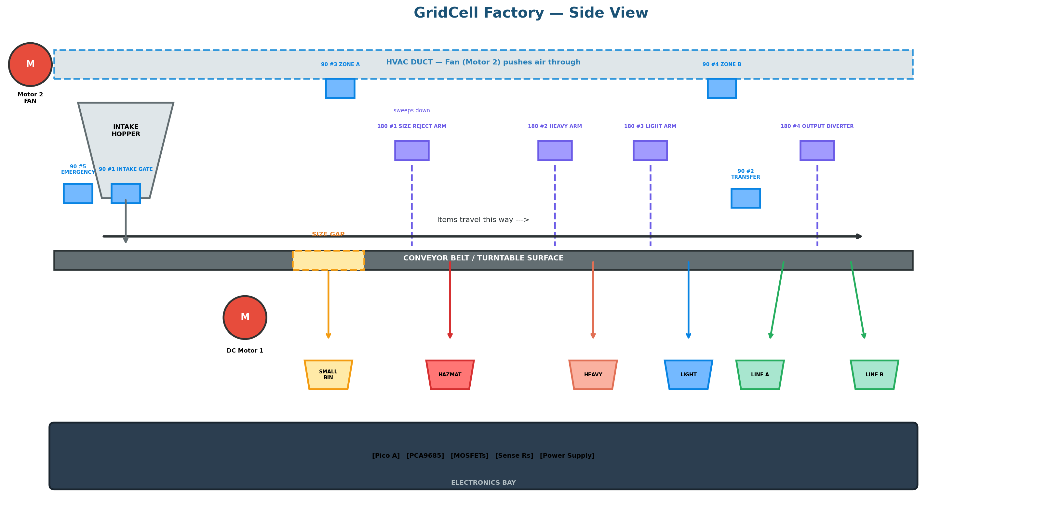
docs/images/factory_side_view_full.png
