doyun-gu/hack-a-bot-2026/docs/images/factory_top_view_full.png

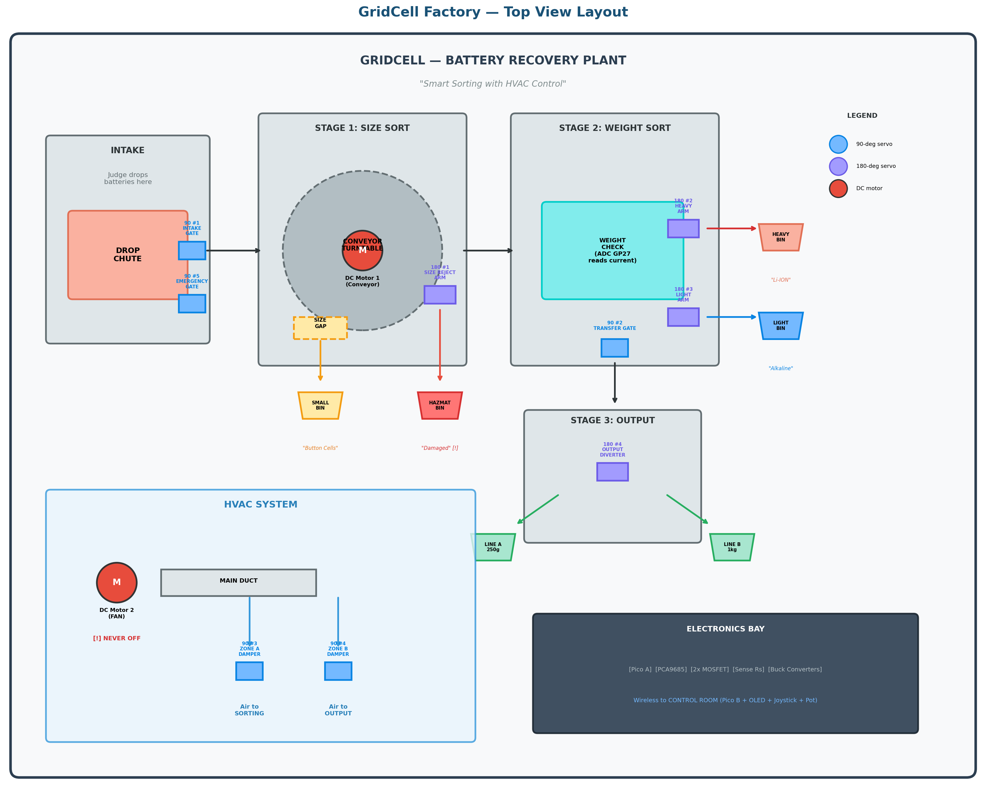
docs/images/factory_top_view_full.png
