doyun-gu/hack-a-bot-2026/docs/images/nrf_pinout_front_back.png

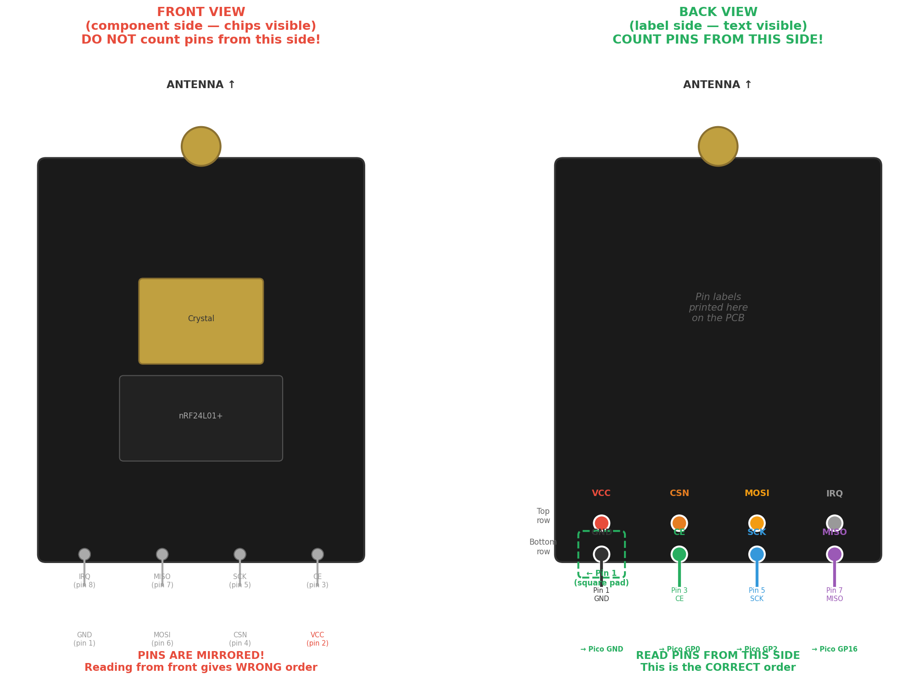
docs/images/nrf_pinout_front_back.png
