doyun-gu/hack-a-bot-2026/docs/images/schematic_i2c_bus.png

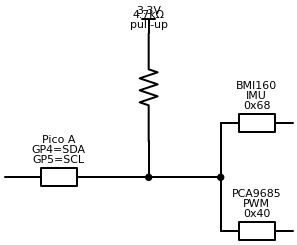
docs/images/schematic_i2c_bus.png
