doyun-gu/hack-a-bot-2026/docs/images/schematic_motor_switch.png

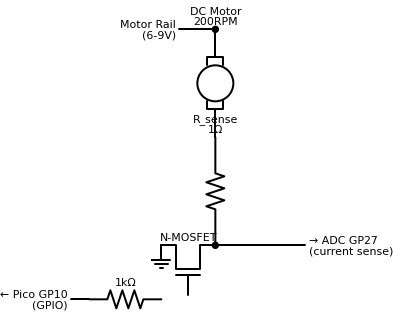
docs/images/schematic_motor_switch.png
