doyun-gu/hack-a-bot-2026/docs/images/schematic_power.png

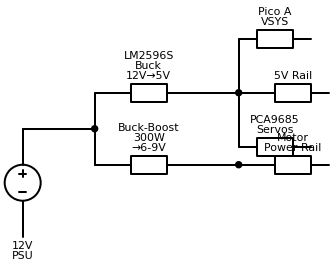
docs/images/schematic_power.png
