doyun-gu/hack-a-bot-2026/docs/images/schematic_voltage_divider.png

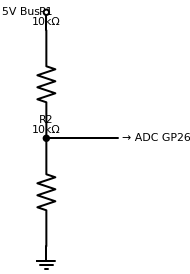
docs/images/schematic_voltage_divider.png
