doyun-gu/hack-a-bot-2026/docs/images/steadyhand_architecture.png

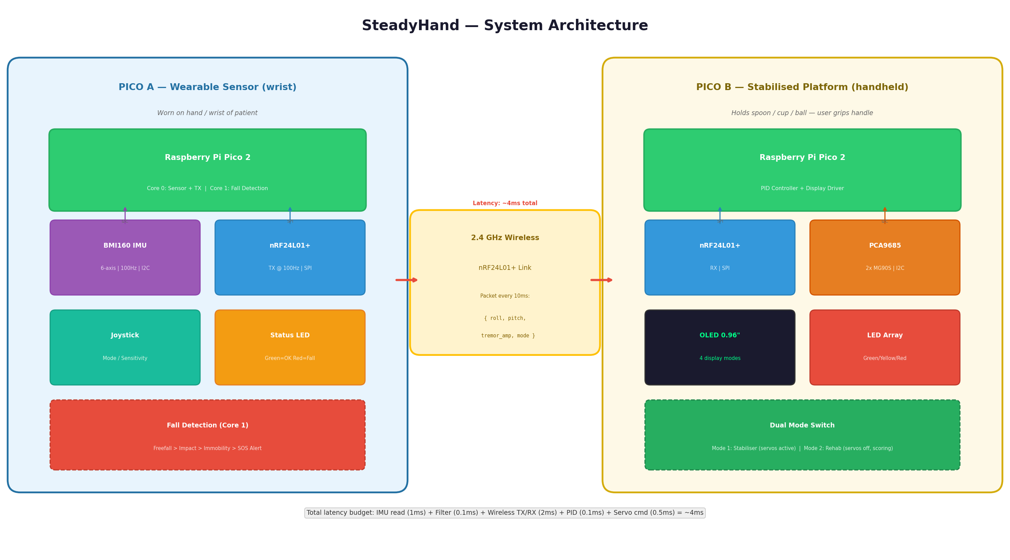
docs/images/steadyhand_architecture.png
