doyun-gu/hack-a-bot-2026/docs/images/steadyhand_demo.png

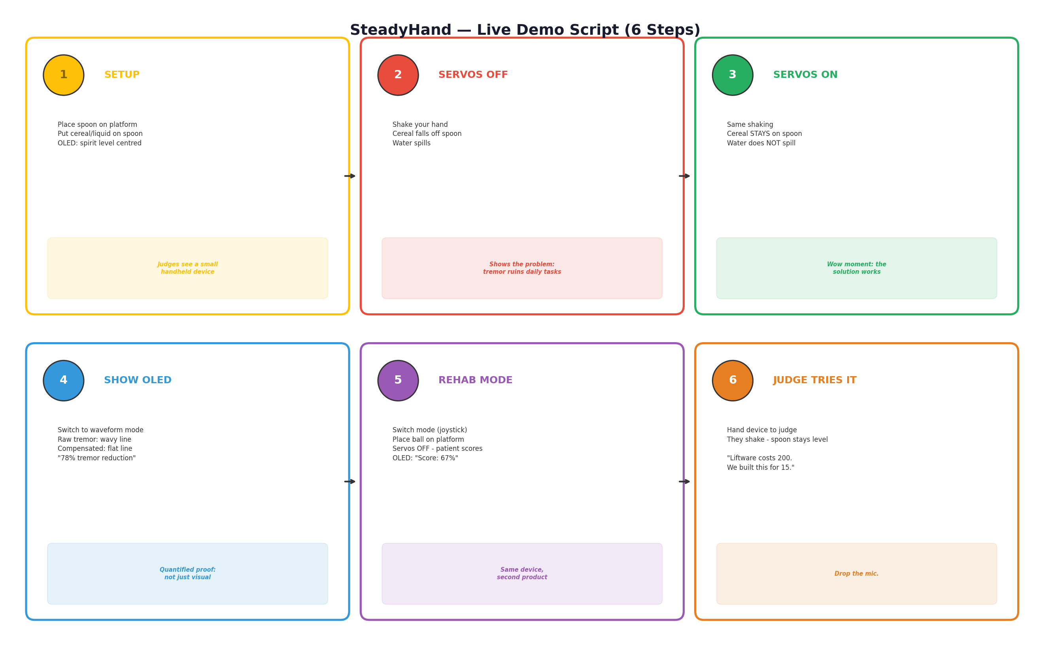
docs/images/steadyhand_demo.png
