doyun-gu/hack-a-bot-2026/docs/images/steadyhand_mechanical.png

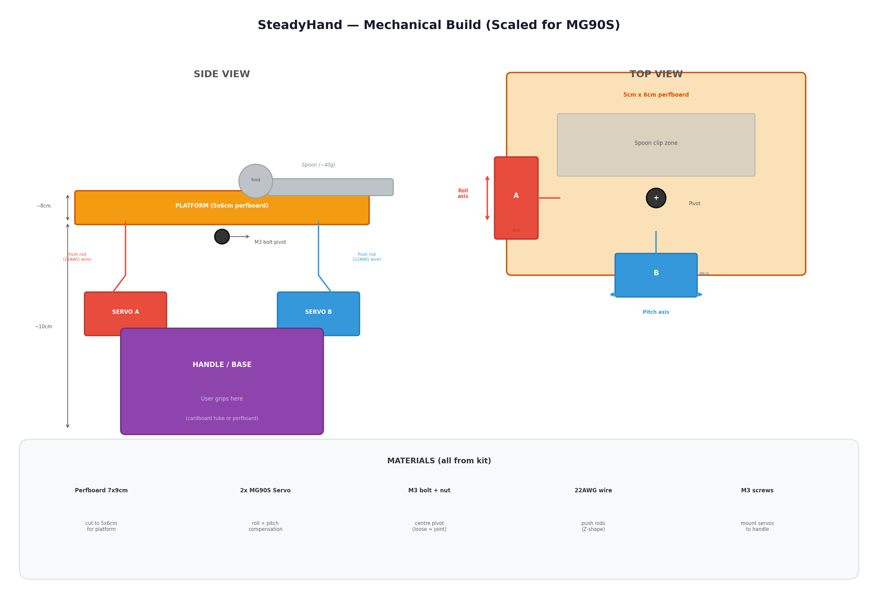
docs/images/steadyhand_mechanical.png
