doyun-gu/hack-a-bot-2026/docs/images/steadyhand_oled_modes.png

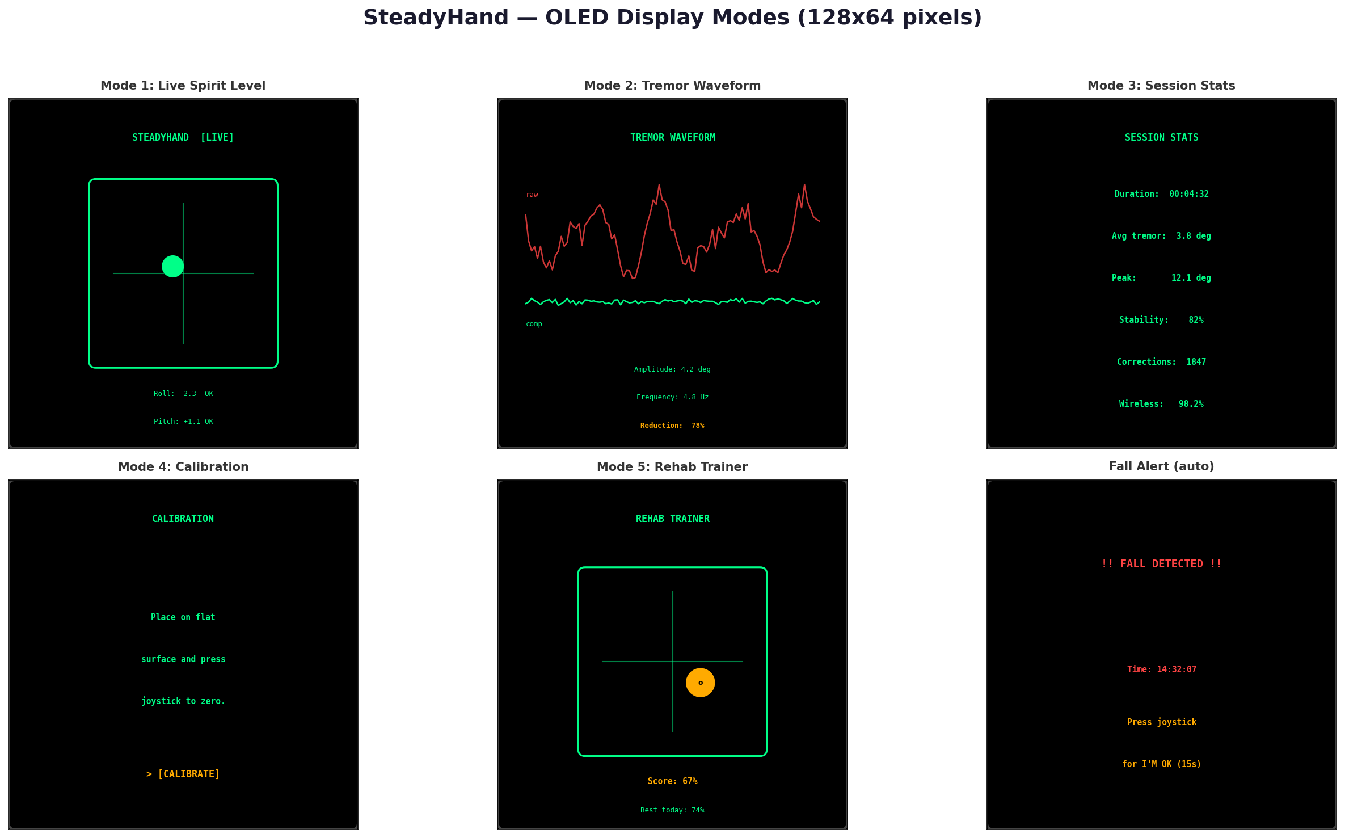
docs/images/steadyhand_oled_modes.png
