doyun-gu/hack-a-bot-2026/src/hardware/cad/fast-print/sort body.stl

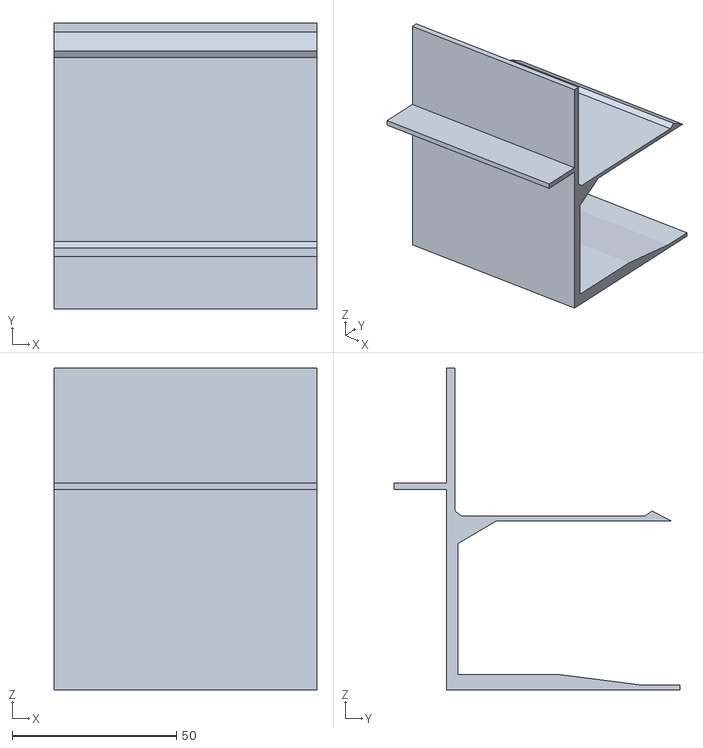
[picture p49: CAD file, 2026-03-22]
src/hardware/cad/fast-print/sort body.stl
80.0 x 87.0 x 98.0
