doyun-gu/hack-a-bot-2026/src/hardware/cad/full-design/Wheel v1.step

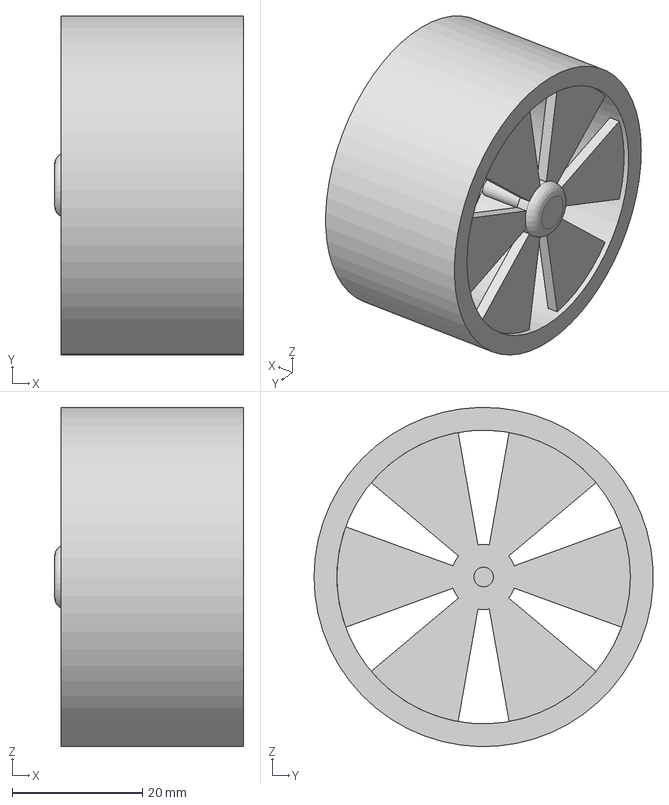
[picture p50: CAD file, 2026-03-22]
src/hardware/cad/full-design/Wheel v1.step
29.0 x 52.0 x 52.0 mm
