doyun-gu/hack-a-bot-2026/src/hardware/cad/servo-mg90s/Four directed shoulder.STEP

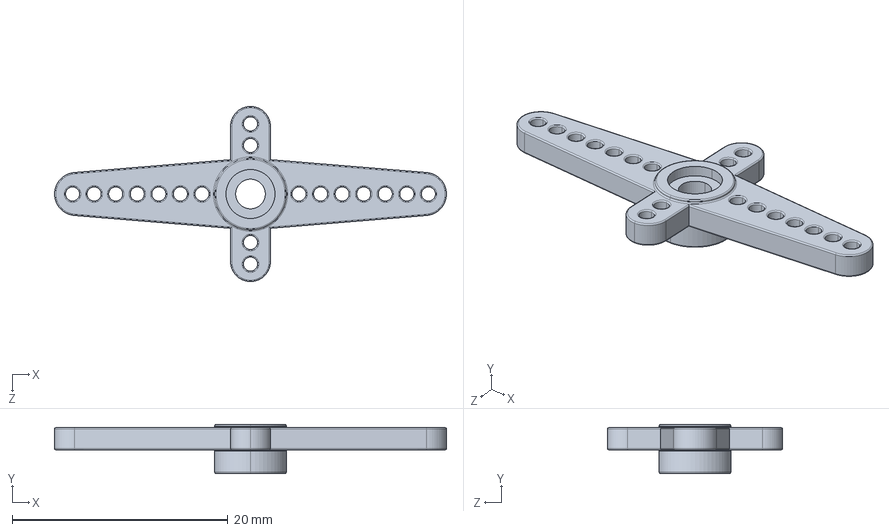
[picture p51: CAD file, 2026-03-22]
src/hardware/cad/servo-mg90s/Four directed shoulder.STEP
36.3 x 4.55 x 16.2 mm
