doyun-gu/hack-a-bot-2026/src/hardware/cad/full-design/funnel.stl

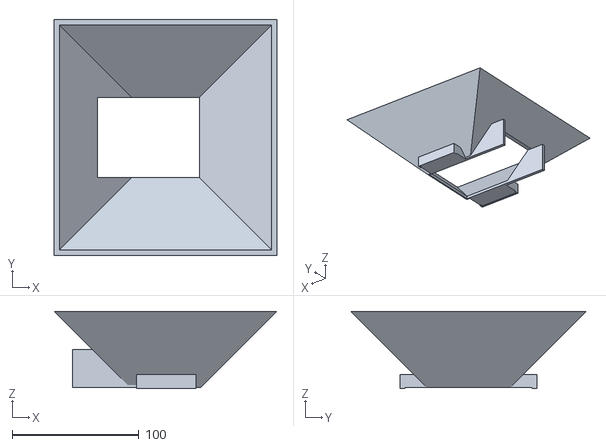
[picture p53: CAD file, 2026-03-22]
src/hardware/cad/full-design/funnel.stl
176.0 x 186.0 x 61.0
