doyun-gu/hack-a-bot-2026/src/hardware/cad/servo-mg90s/Unidirectional shoulder.STEP

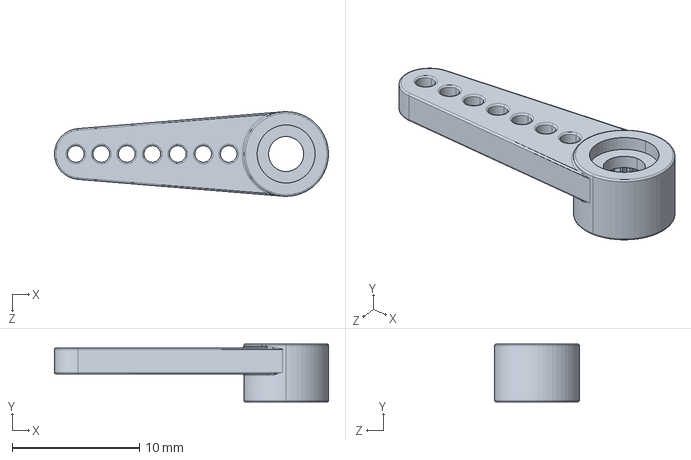
[picture p54: CAD file, 2026-03-22]
src/hardware/cad/servo-mg90s/Unidirectional shoulder.STEP
21.5 x 4.55 x 6.65 mm
