doyun-gu/hack-a-bot-2026/src/hardware/cad/fast-print/motor.stl

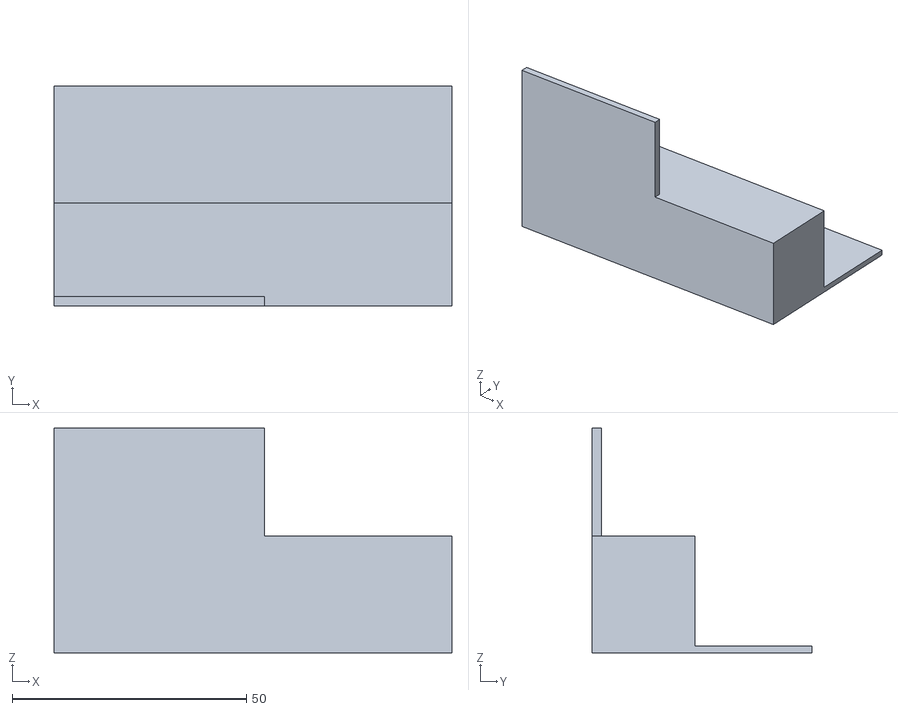
[picture p55: CAD file, 2026-03-22]
src/hardware/cad/fast-print/motor.stl
85.0 x 47.0 x 48.0
