doyun-gu/hack-a-bot-2026/src/hardware/cad/full-design/Bearing.stl

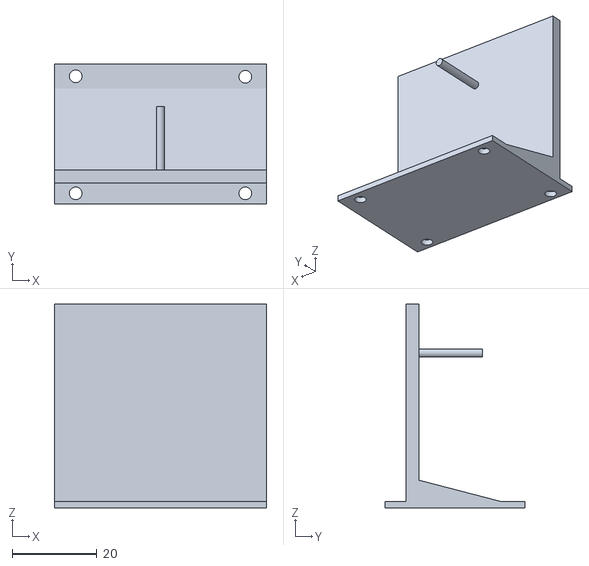
[picture p56: CAD file, 2026-03-22]
src/hardware/cad/full-design/Bearing.stl
50.0 x 33.0 x 48.0
