doyun-gu/hack-a-bot-2026/src/hardware/cad/servo-mg90s/Bidirectional shoulder.STEP

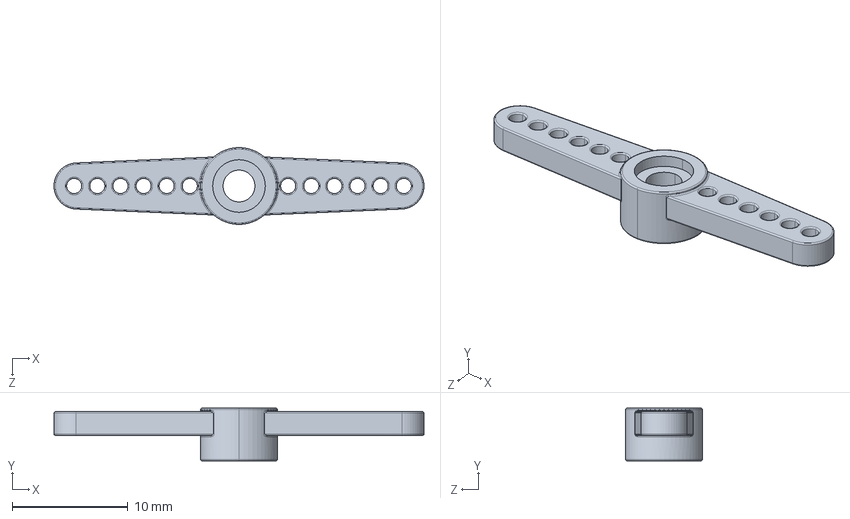
[picture p57: CAD file, 2026-03-22]
src/hardware/cad/servo-mg90s/Bidirectional shoulder.STEP
32.0 x 4.55 x 6.65 mm
