doyun-gu/hack-a-bot-2026/src/hardware/cad/fast-print/bearing.stl

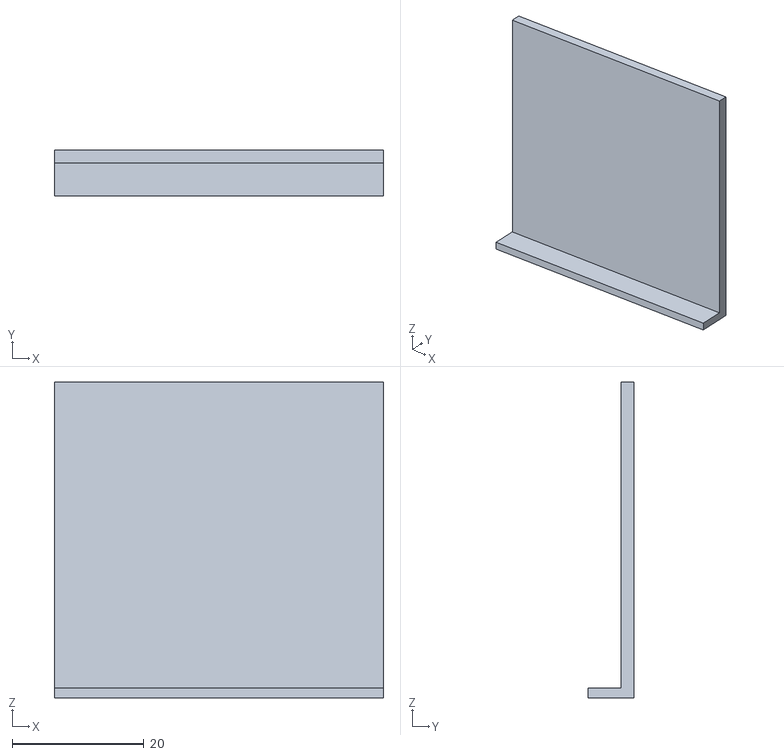
[picture p58: CAD file, 2026-03-22]
src/hardware/cad/fast-print/bearing.stl
50.0 x 7.00 x 48.0
