doyun-gu/hack-a-bot-2026/src/hardware/cad/full-design/motorlowerqual.stl

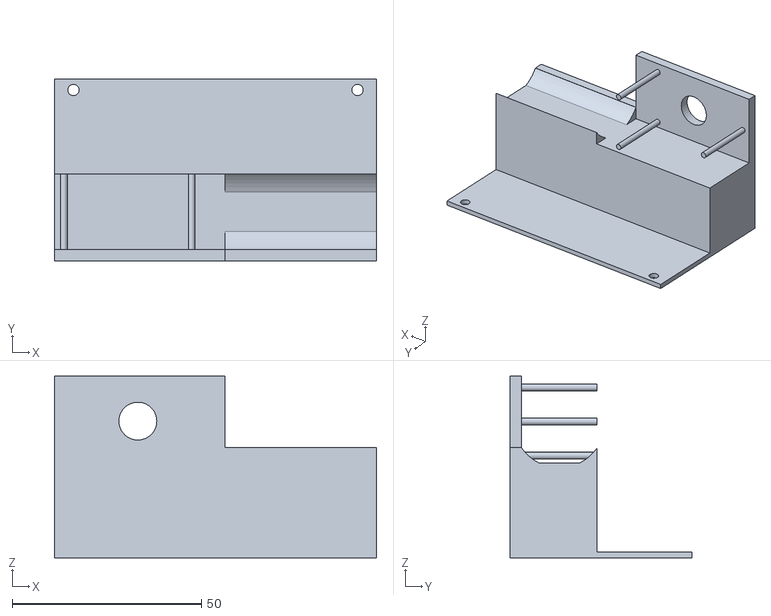
[picture p59: CAD file, 2026-03-22]
src/hardware/cad/full-design/motorlowerqual.stl
85.0 x 48.0 x 48.0
