doyun-gu/hack-a-bot-2026/src/hardware/cad/servo-mg90s/Tower Pro MG90S Micro servo.STEP

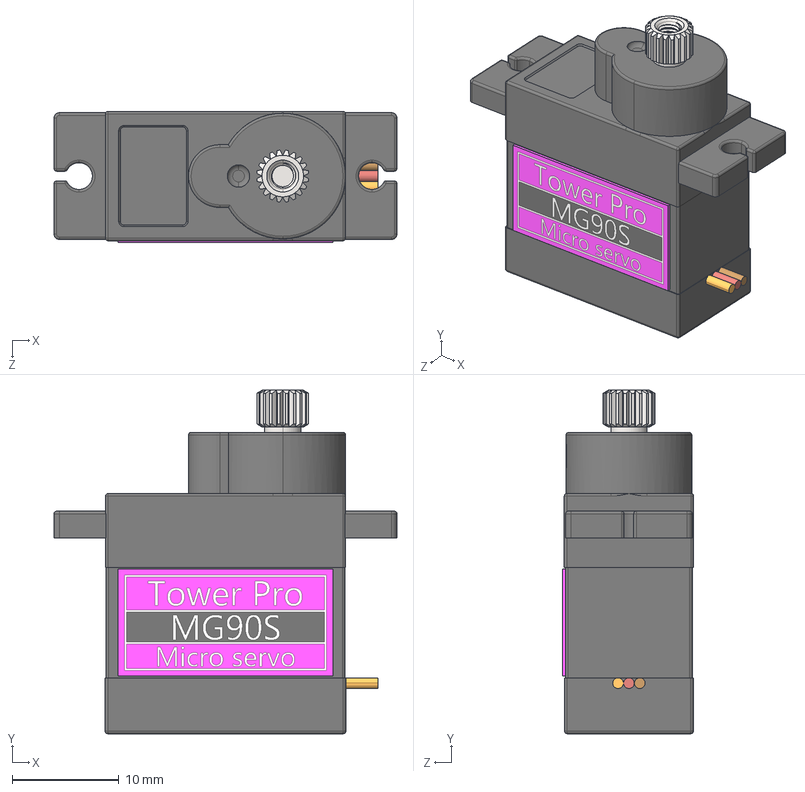
[picture p60: CAD file, 2026-03-22]
src/hardware/cad/servo-mg90s/Tower Pro MG90S Micro servo.STEP
32.2 x 32.2 x 12.3 mm
