doyun-gu/hack-a-bot-2026/src/hardware/cad/fast-print/block.stl

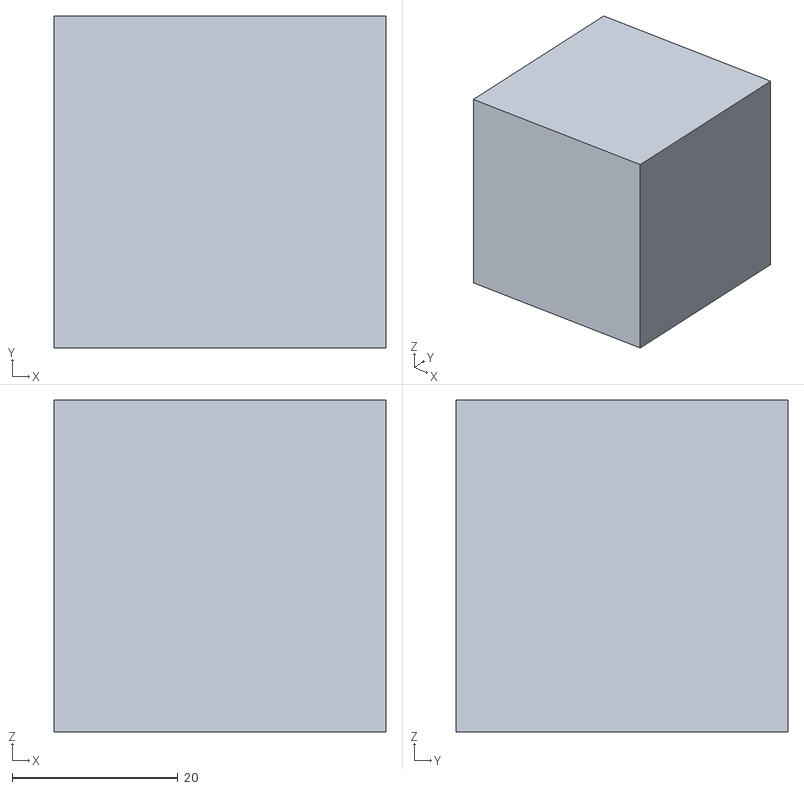
[picture p61: CAD file, 2026-03-22]
src/hardware/cad/fast-print/block.stl
40.0 x 40.0 x 40.0
