doyun-gu/hack-a-bot-2026/src/hardware/cad/full-design/Objects v2.step

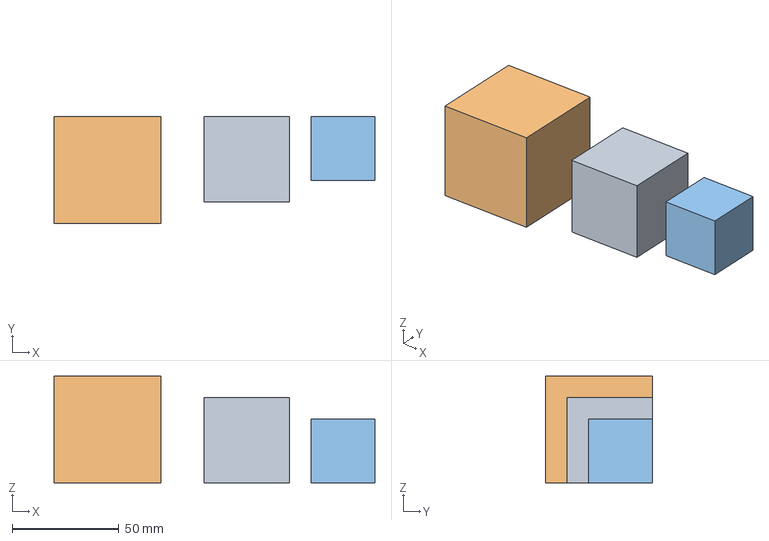
[picture p62: CAD file, 2026-03-22]
src/hardware/cad/full-design/Objects v2.step
150.0 x 50.0 x 50.0 mm
