doyun-gu/hack-a-bot-2026/src/hardware/cad/fast-print/fast side.stl

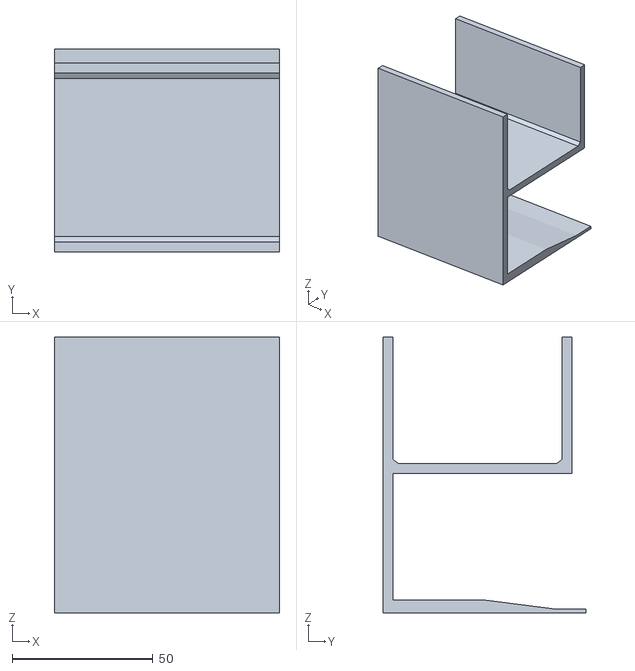
[picture p63: CAD file, 2026-03-22]
src/hardware/cad/fast-print/fast side.stl
80.0 x 72.0 x 98.0
