doyun-gu/hack-a-bot-2026/src/hardware/cad/full-design/Conveyor motor v5.step

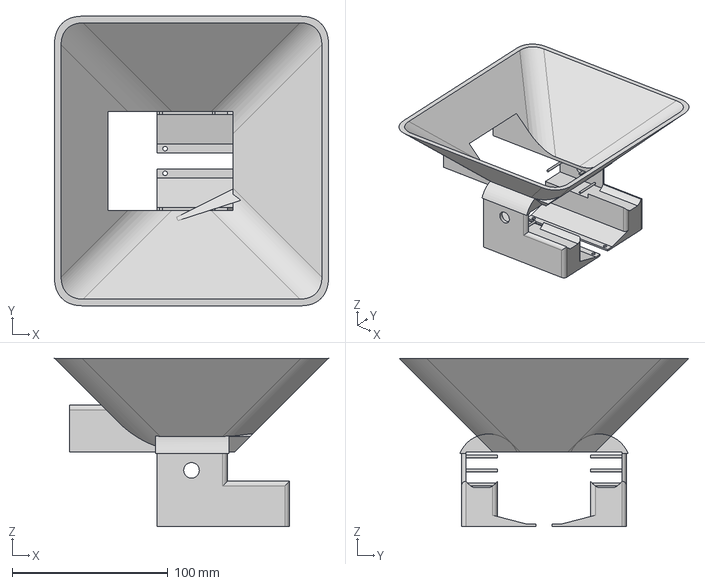
[picture p64: CAD file, 2026-03-22]
src/hardware/cad/full-design/Conveyor motor v5.step
176.0 x 186.0 x 108.0 mm
