doyun-gu/hack-a-bot-2026/src/hardware/cad/full-design/slope.stl

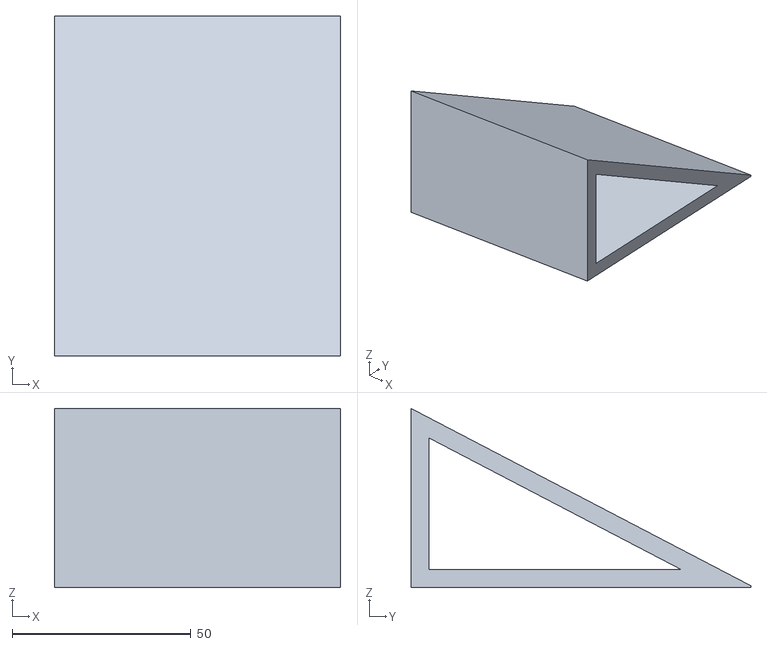
[picture p65: CAD file, 2026-03-22]
src/hardware/cad/full-design/slope.stl
80.0 x 95.0 x 50.1
