doyun-gu/hack-a-bot-2026/src/hardware/cad/full-design/Conveyor Bearing v2.step

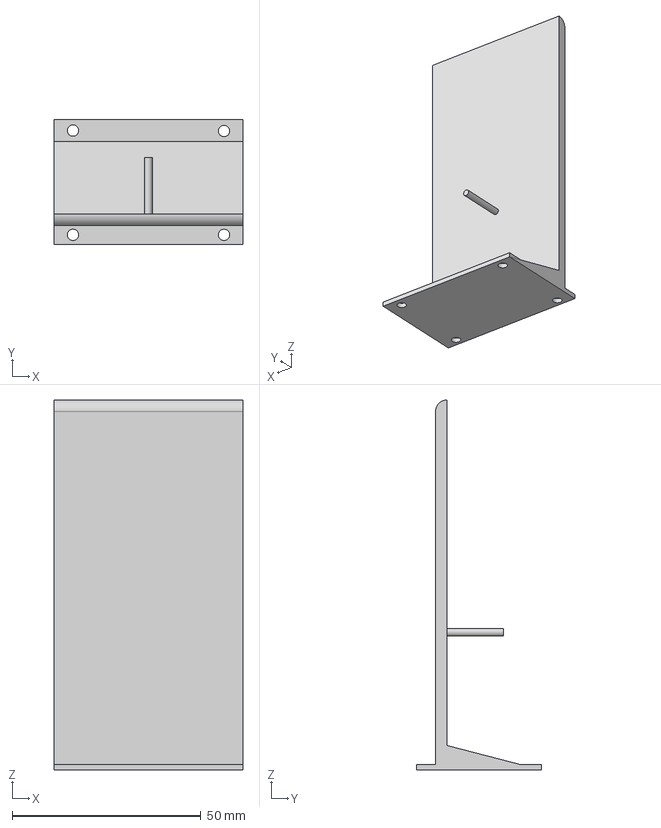
[picture p66: CAD file, 2026-03-22]
src/hardware/cad/full-design/Conveyor Bearing v2.step
50.0 x 33.0 x 98.0 mm
