doyun-gu/hack-a-bot-2026/src/hardware/cad/full-design/Belt Cover v5.step

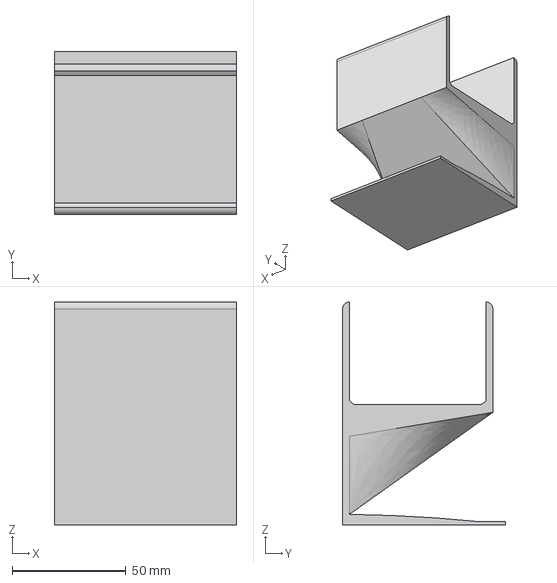
[picture p67: CAD file, 2026-03-22]
src/hardware/cad/full-design/Belt Cover v5.step
80.0 x 71.5 x 98.0 mm
