doyun-gu/hack-a-bot-2026/src/hardware/cad/full-design/Sorter v3.step

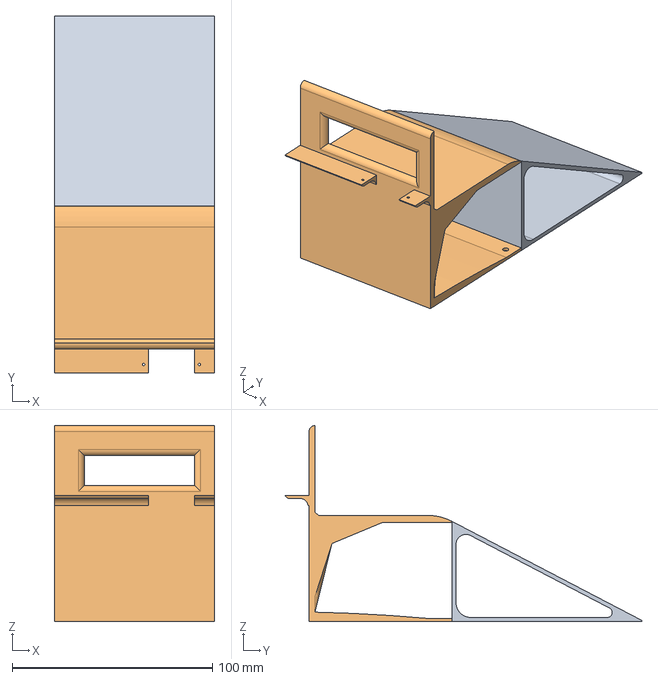
[picture p68: CAD file, 2026-03-22]
src/hardware/cad/full-design/Sorter v3.step
80.0 x 178.5 x 98.0 mm
