doyun-gu/hack-a-bot-2026/src/hardware/cad/full-design/conveyortmotor.stl

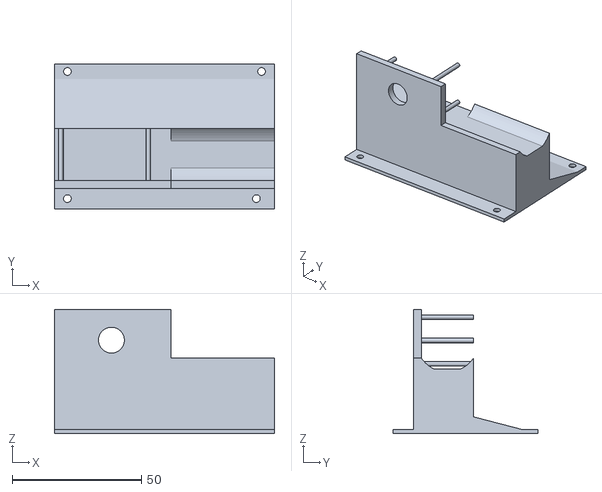
[picture p69: CAD file, 2026-03-22]
src/hardware/cad/full-design/conveyortmotor.stl
85.0 x 56.0 x 48.0
