doyun-gu/hack-a-bot-2026/src/hardware/cad/full-design/sidebar.stl

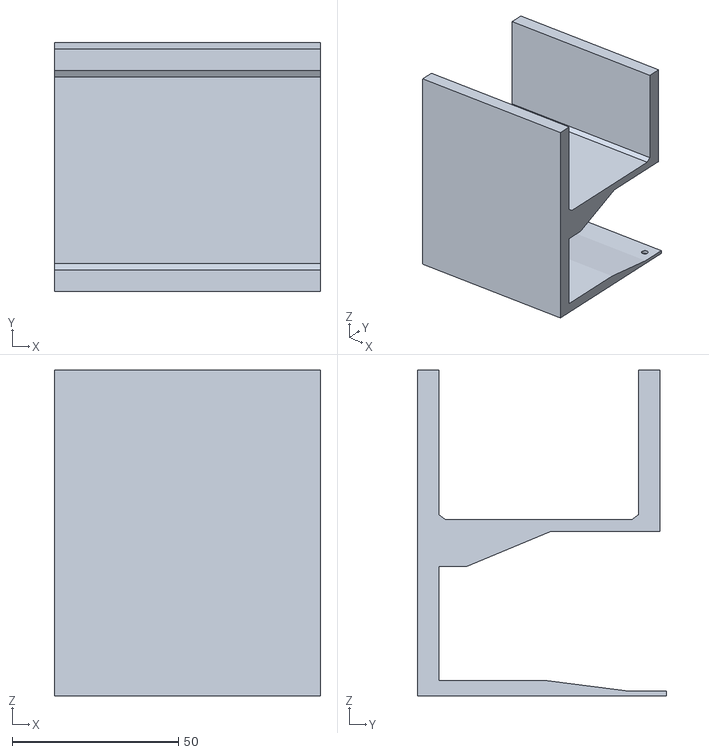
[picture p70: CAD file, 2026-03-22]
src/hardware/cad/full-design/sidebar.stl
80.0 x 75.0 x 98.0
