doyun-gu/hack-a-bot-2026/(list of files, cad)

Other CAD files:
src/hardware/cad/fast-print/side bar.stl
src/hardware/cad/full-design/sort.stl
