doyun-gu/hack-a-bot-2026/firmware/03-v3/c_sdk/pca9685.c

/**
 * GridBox — PCA9685 16-Channel PWM Driver (C SDK)
 * Stub implementation — prints function calls for testing.
 */

#include "pca9685.h"
#include <stdio.h>

bool pca9685_init(pca9685_t *dev, i2c_inst_t *i2c, uint8_t addr, uint16_t freq_hz) {
    printf("[STUB] pca9685_init(addr=0x%02X, freq=%dHz)\n", addr, freq_hz);

    dev->i2c = i2c;
    dev->addr = addr;

    /* TODO: Write RESTART to MODE1 */
    /* TODO: Set auto-increment (AI | ALLCALL) */
    /* TODO: Call pca9685_set_frequency(dev, freq_hz) */

    return true;
}

void pca9685_set_frequency(pca9685_t *dev, uint16_t freq_hz) {
    printf("[STUB] pca9685_set_frequency(%dHz)\n", freq_hz);
    /* TODO: Calculate prescale = 25MHz / (4096 * freq) - 1 */
    /* TODO: Sleep, write PRE_SCALE, wake */
}

void pca9685_set_pwm(pca9685_t *dev, uint8_t channel, uint16_t on, uint16_t off) {
    printf("[STUB] pca9685_set_pwm(ch=%d, on=%d, off=%d)\n", channel, on, off);
    /* TODO: Write 4 bytes to LED0_ON_L + 4*channel */
}

void pca9685_set_duty(pca9685_t *dev, uint8_t channel, uint8_t duty_percent) {
    printf("[STUB] pca9685_set_duty(ch=%d, %d%%)\n", channel, duty_percent);
    /* TODO: Convert percent to 12-bit off value, call set_pwm */
    if (duty_percent <= 0) {
        pca9685_set_pwm(dev, channel, 0, 0);
    } else if (duty_percent >= 100) {
        pca9685_set_pwm(dev, channel, 4096, 0);
    } else {
        uint16_t off = (uint16_t)(duty_percent * PCA9685_RESOLUTION / 100);
        pca9685_set_pwm(dev, channel, 0, off);
    }
}

void pca9685_set_servo_angle(pca9685_t *dev, uint8_t channel, uint16_t angle) {
    printf("[STUB] pca9685_set_servo_angle(ch=%d, %d°)\n", channel, angle);
    /* TODO: Map angle to pulse width: 500us (0°) to 2500us (180°) */
    /* TODO: Convert to 12-bit value at 50Hz (20ms period) */
    float pulse_us = 500.0f + (angle / 180.0f) * 2000.0f;
    uint16_t off = (uint16_t)(pulse_us / 20000.0f * PCA9685_RESOLUTION);
    pca9685_set_pwm(dev, channel, 0, off);
}

void pca9685_set_motor_speed(pca9685_t *dev, uint8_t channel, uint8_t speed_percent) {
    printf("[STUB] pca9685_set_motor_speed(ch=%d, %d%%)\n", channel, speed_percent);
    uint8_t clamped = speed_percent > 100 ? 100 : speed_percent;
    pca9685_set_duty(dev, channel, clamped);
}

void pca9685_off(pca9685_t *dev, uint8_t channel) {
    printf("[STUB] pca9685_off(ch=%d)\n", channel);
    pca9685_set_pwm(dev, channel, 0, 0);
}

void pca9685_all_off(pca9685_t *dev) {
    printf("[STUB] pca9685_all_off()\n");
    /* TODO: Write 4 zero bytes to ALL_LED_ON_L register */
}
